hrx2025lucky-lab/flyarm-aerial-manipulation/assets_3d/README.md

# 3D 装配体

此目录用于存放机体与机械臂的 SolidWorks 装配体 / 零件文件。

URDF 与 STL 网格见上一级目录 `../urdf/`。
