hrx2025lucky-lab/flyarm-aerial-manipulation/docs/images/training_comparison/original/cmp_01_bar_level.png

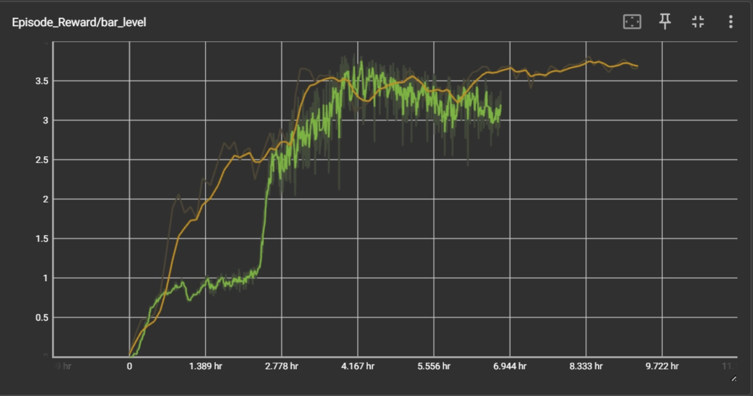
docs/images/training_comparison/original/cmp_01_bar_level.png
