hrx2025lucky-lab/flyarm-aerial-manipulation/docs/images/training_comparison/original/cmp_02_coop_grasp.png

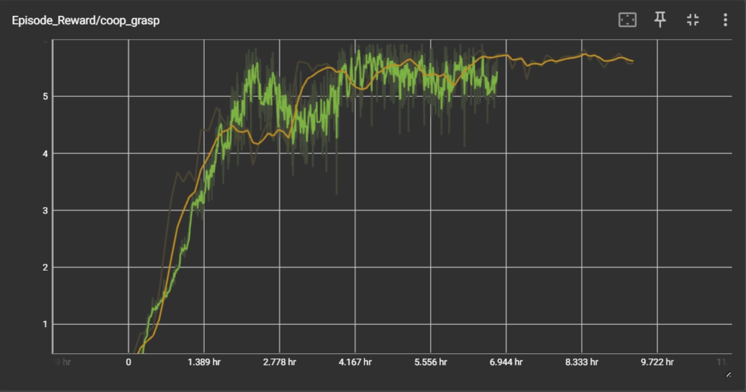
docs/images/training_comparison/original/cmp_02_coop_grasp.png
