hrx2025lucky-lab/flyarm-aerial-manipulation/docs/images/training_comparison/original/cmp_03_hold_bonus.png

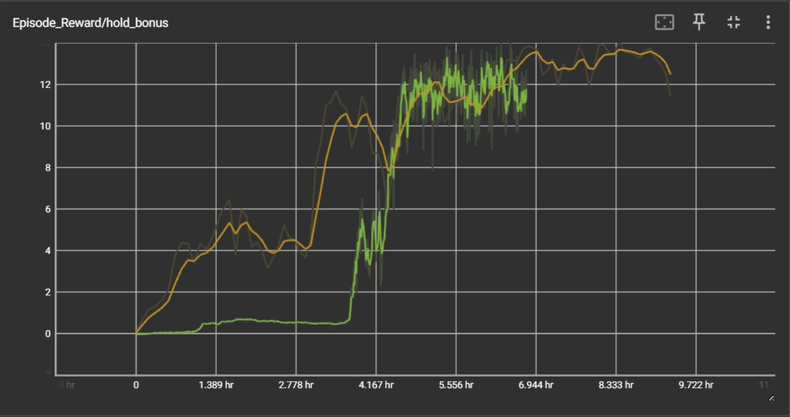
docs/images/training_comparison/original/cmp_03_hold_bonus.png
