hrx2025lucky-lab/flyarm-aerial-manipulation/docs/images/training_comparison/original/cmp_04_died.png

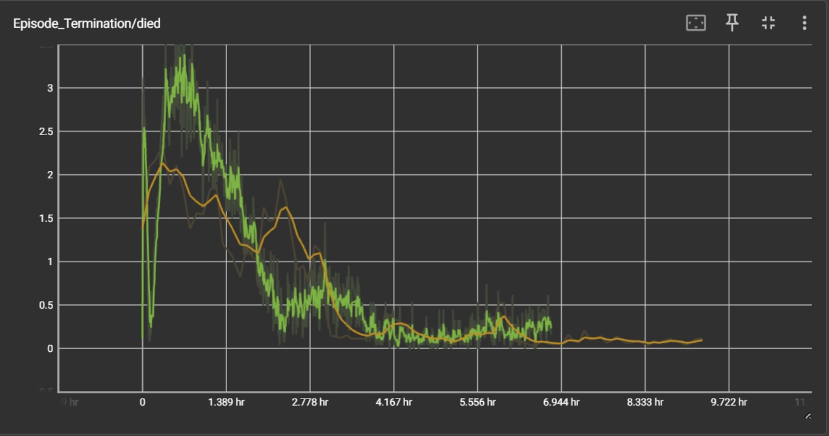
docs/images/training_comparison/original/cmp_04_died.png
