hrx2025lucky-lab/flyarm-aerial-manipulation/docs/images/training_comparison/original/cmp_05_all_contact_frac.png

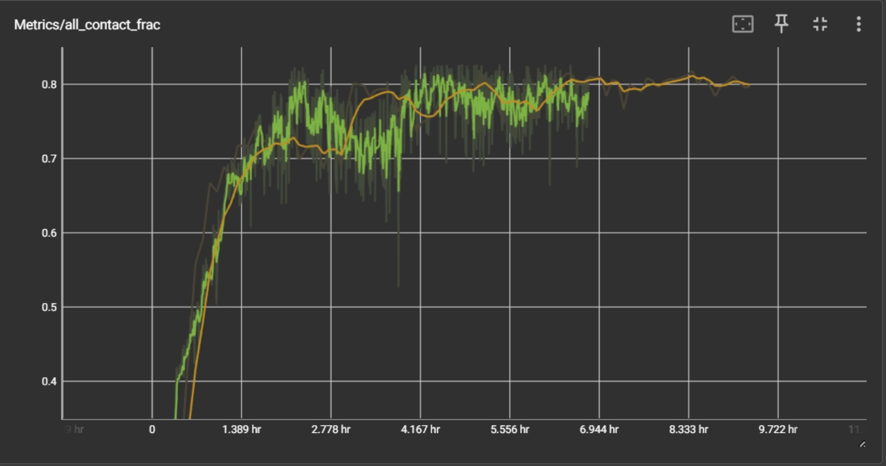
docs/images/training_comparison/original/cmp_05_all_contact_frac.png
