hrx2025lucky-lab/flyarm-aerial-manipulation/docs/images/training_comparison/original/cmp_06_contact_rate_0.png

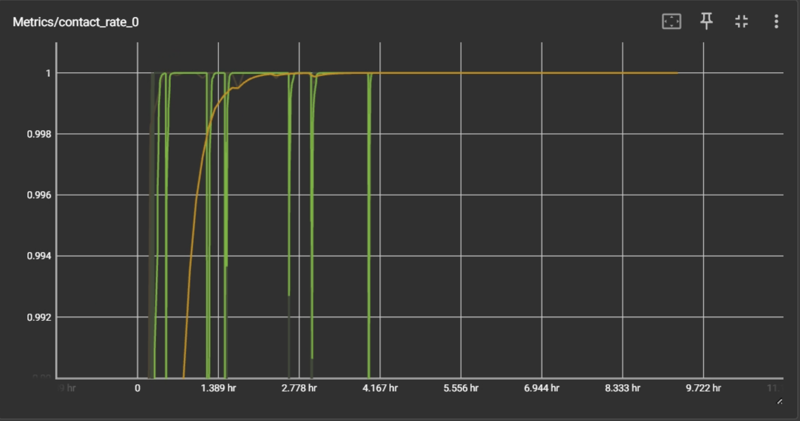
docs/images/training_comparison/original/cmp_06_contact_rate_0.png
