hrx2025lucky-lab/flyarm-aerial-manipulation/docs/images/training_comparison/original/cmp_07_contact_rate_1.png

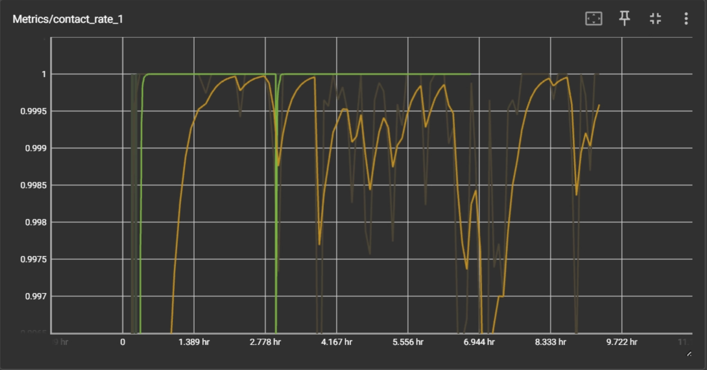
docs/images/training_comparison/original/cmp_07_contact_rate_1.png
