hrx2025lucky-lab/flyarm-aerial-manipulation/docs/images/training_comparison/original/cmp_08_max_bar_height.png

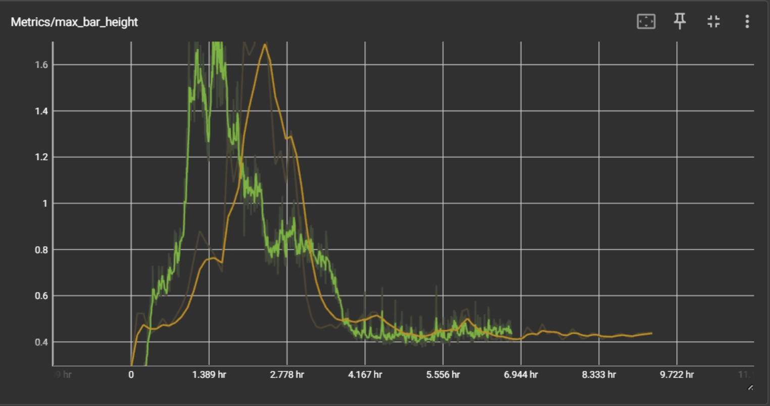
docs/images/training_comparison/original/cmp_08_max_bar_height.png
