hrx2025lucky-lab/flyarm-aerial-manipulation/docs/images/training_comparison/original/cmp_09_max_weak_finger_0.png

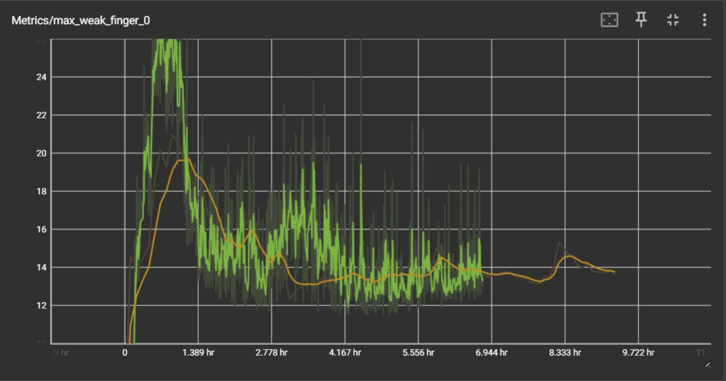
docs/images/training_comparison/original/cmp_09_max_weak_finger_0.png
