hrx2025lucky-lab/flyarm-aerial-manipulation/docs/images/training_comparison/original/cmp_10_max_weak_finger_1.png

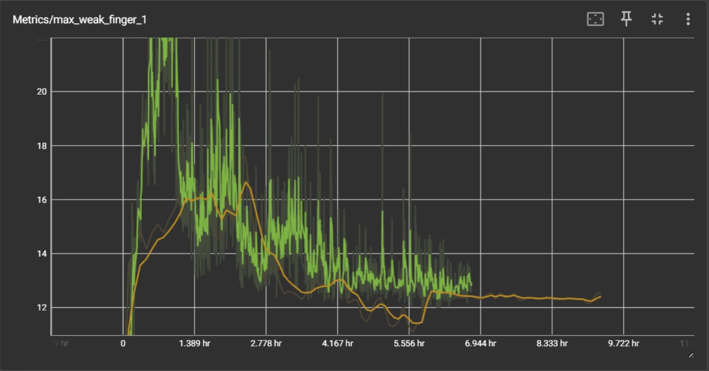
docs/images/training_comparison/original/cmp_10_max_weak_finger_1.png
