hrx2025lucky-lab/flyarm-aerial-manipulation/docs/images/training_comparison/original/cmp_11_success_rate.png

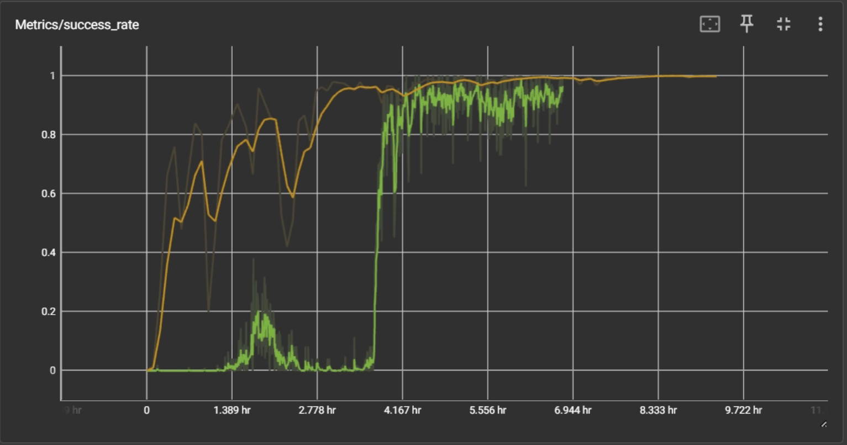
docs/images/training_comparison/original/cmp_11_success_rate.png
