hrx2025lucky-lab/flyarm-aerial-manipulation/assets_3d/3d打印零件/3d打印零件.SLDASM

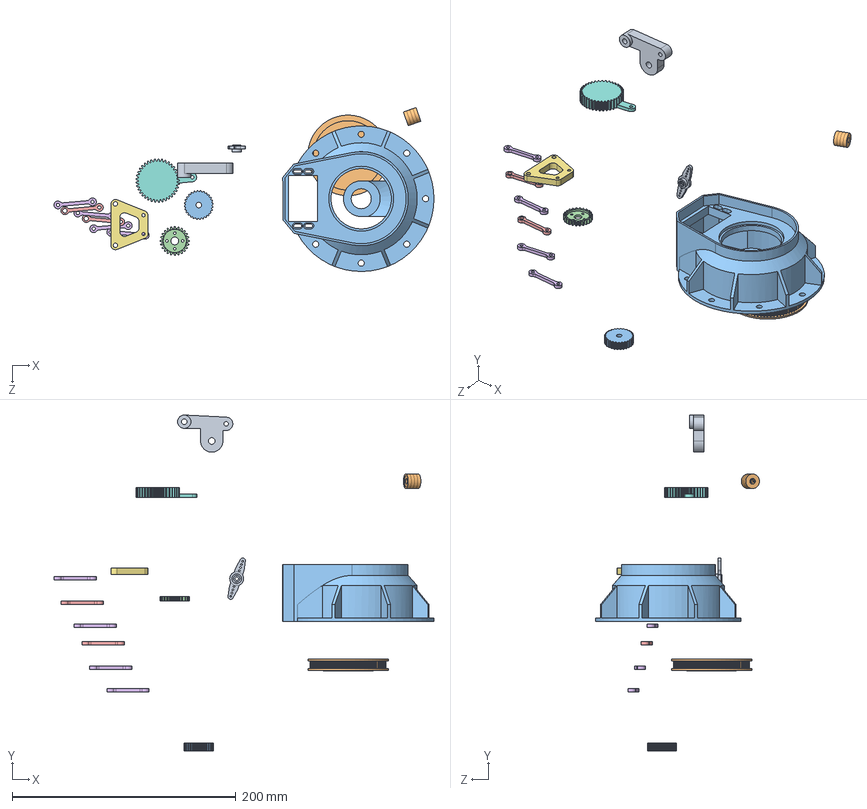
[picture p28: CAD file, 2026-09-01]
assets_3d/3d打印零件/3d打印零件.SLDASM
339.4 x 300.1 x 146.4 mm
固定底座
HTPA72S3M060_A_H8_b
三角形连杆
上从动齿直齿M1X37
夹爪连接件
grip part 3 x 4
从动齿轮轴下连杆 x 2
主动齿直齿M1X24
HTPA28S3M060_A_H5_b
B轴轴承压块 x 4
舵机单臂舵盘渲染2018
