hrx2025lucky-lab/flyarm-aerial-manipulation/assets_3d/旋转夹爪机械臂/HTPA28S3M060_A_H5.SLDASM

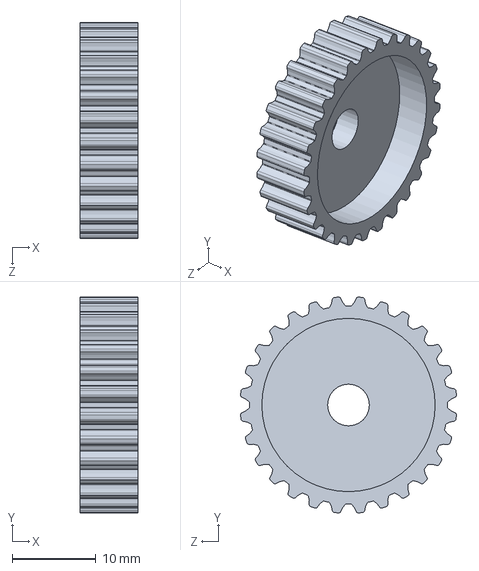
[picture p29: CAD file, 2026-09-01]
assets_3d/旋转夹爪机械臂/HTPA28S3M060_A_H5.SLDASM
7.00 x 25.9 x 25.9 mm
