hrx2025lucky-lab/flyarm-aerial-manipulation/assets_3d/旋转夹爪机械臂/HTPA72S3M060_A_H8.SLDASM

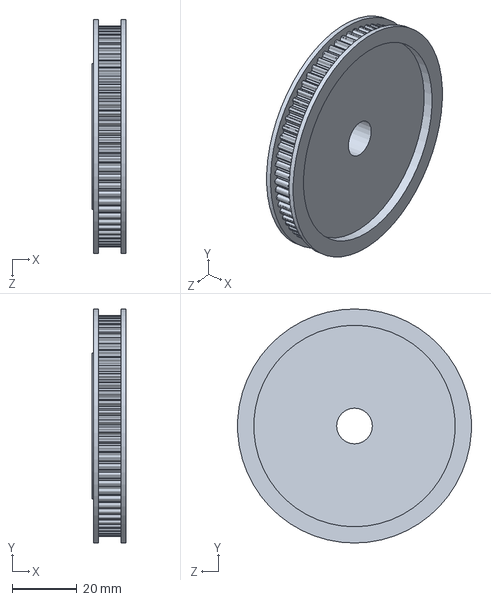
[picture p30: CAD file, 2026-09-01]
assets_3d/旋转夹爪机械臂/HTPA72S3M060_A_H8.SLDASM
10.5 x 72.0 x 71.9 mm
