hrx2025lucky-lab/flyarm-aerial-manipulation/assets_3d/3d打印零件/夹爪装配体 - grip part 3-4.STL

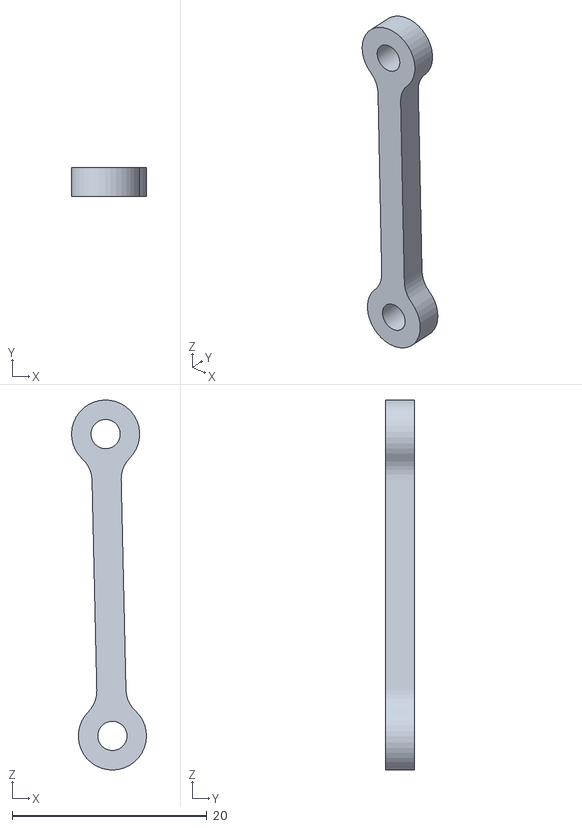
[picture p31: CAD file, 2026-09-01]
assets_3d/3d打印零件/夹爪装配体 - grip part 3-4.STL
7.70 x 3.00 x 38.0
