hrx2025lucky-lab/flyarm-aerial-manipulation/assets_3d/旋转夹爪机械臂/方案-旋转底座.SLDPRT

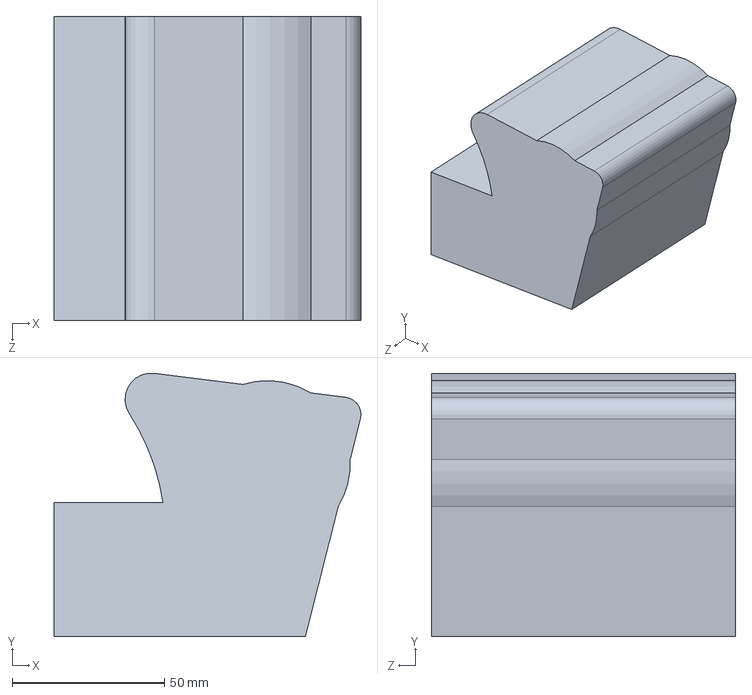
[picture p32: CAD file, 2026-09-01]
assets_3d/旋转夹爪机械臂/方案-旋转底座.SLDPRT
100.9 x 86.5 x 100.0 mm
