hrx2025lucky-lab/flyarm-aerial-manipulation/urdf/meshes/link_bc.STL

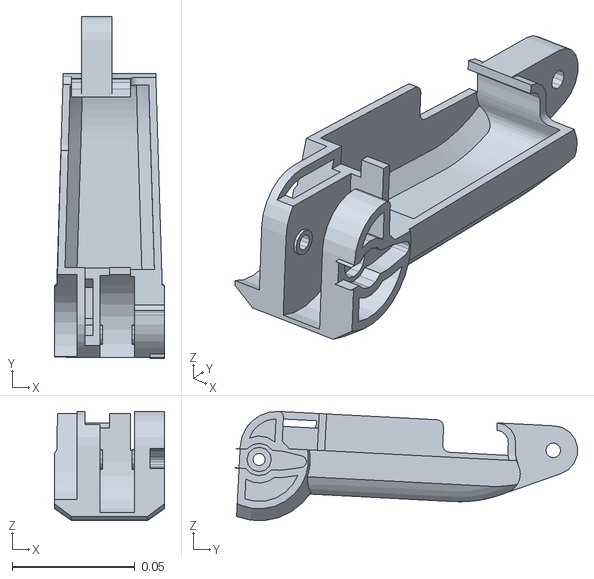
[picture p33: CAD file, 2026-09-01]
urdf/meshes/link_bc.STL
0.045 x 0.139 x 0.0445
