hrx2025lucky-lab/flyarm-aerial-manipulation/urdf/meshes/parallel_gripper/pg_right_finger.STL

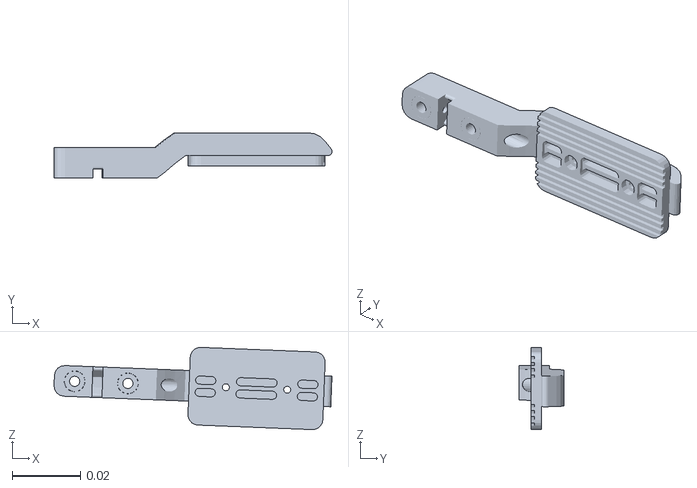
[picture p34: CAD file, 2026-09-01]
urdf/meshes/parallel_gripper/pg_right_finger.STL
0.0815 x 0.0133 x 0.0241
