hrx2025lucky-lab/flyarm-aerial-manipulation/assets_3d/平行夹爪机械臂/内六角圆柱头螺钉 M2x4.SLDPRT

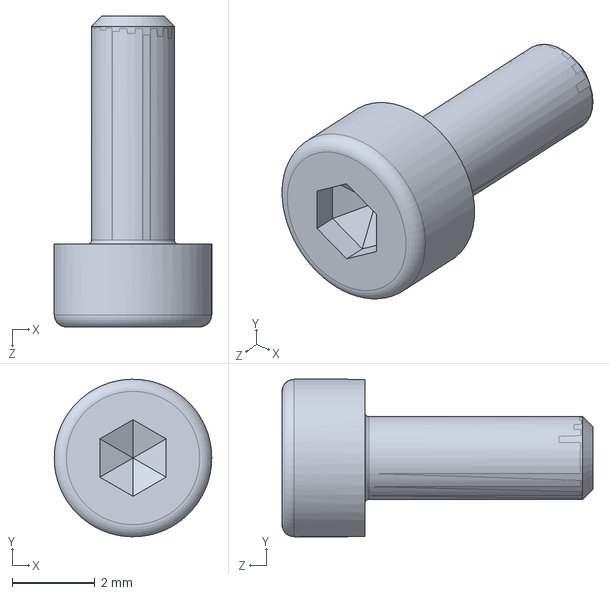
[picture p35: CAD file, 2026-09-01]
assets_3d/平行夹爪机械臂/内六角圆柱头螺钉 M2x4.SLDPRT
3.80 x 3.80 x 7.50 mm
