hrx2025lucky-lab/flyarm-aerial-manipulation/assets_3d/旋转夹爪机械臂/上从动齿直齿M1X37.SLDPRT

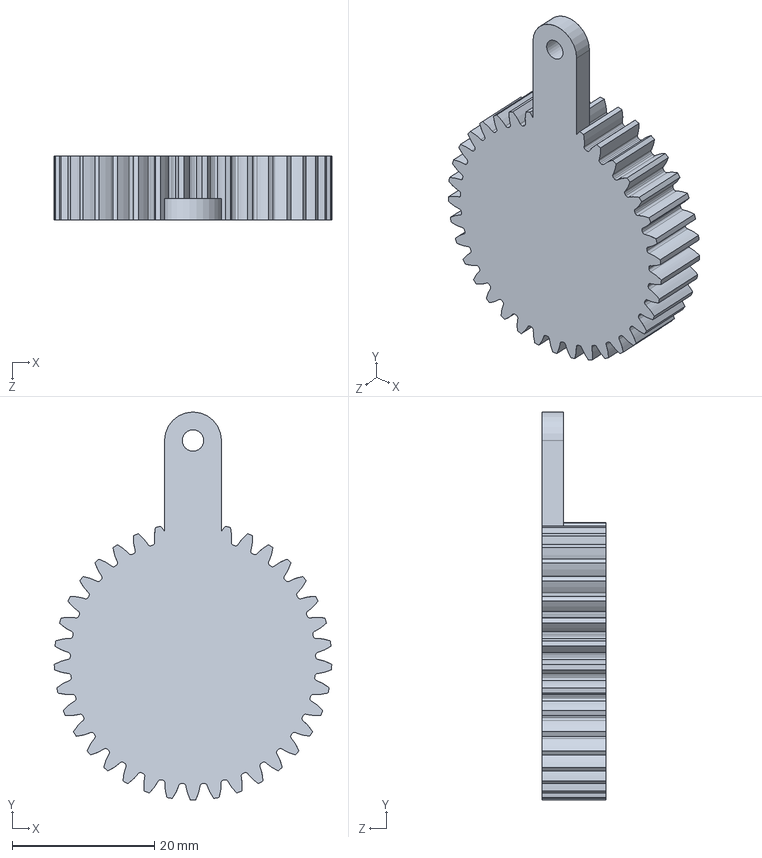
[picture p36: CAD file, 2026-09-01]
assets_3d/旋转夹爪机械臂/上从动齿直齿M1X37.SLDPRT
39.0 x 54.5 x 9.00 mm
