hrx2025lucky-lab/flyarm-aerial-manipulation/urdf/meshes/link_cd.STL

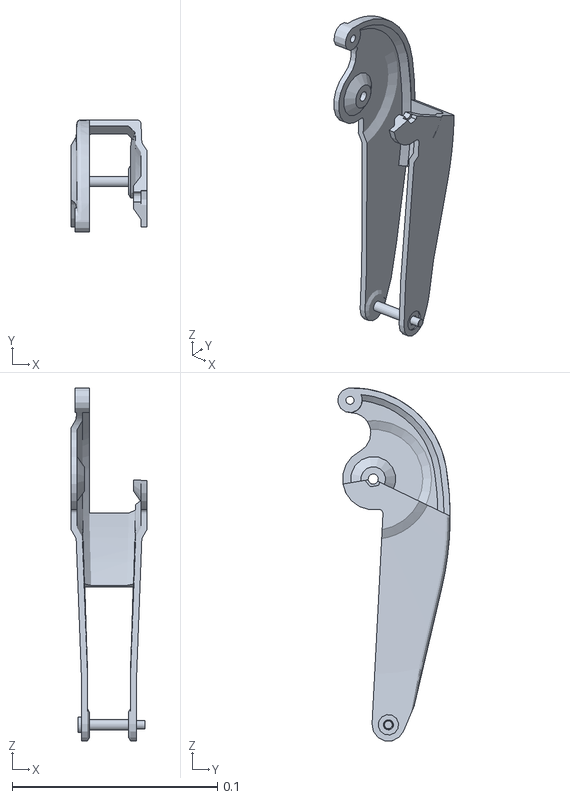
[picture p37: CAD file, 2026-09-01]
urdf/meshes/link_cd.STL
0.037 x 0.0547 x 0.172
