hrx2025lucky-lab/flyarm-aerial-manipulation/urdf/meshes/parallel_gripper/pg_gripper_base.STL

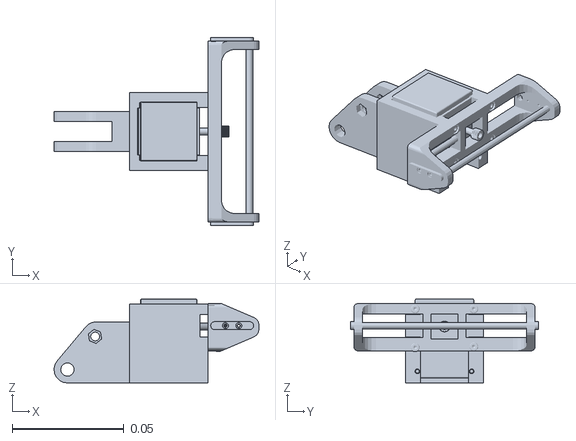
[picture p38: CAD file, 2026-09-01]
urdf/meshes/parallel_gripper/pg_gripper_base.STL
0.0916 x 0.084 x 0.0375
