hrx2025lucky-lab/flyarm-aerial-manipulation/assets_3d/3d打印零件/夹爪装配体 - 从动齿轮轴下连杆-2.STL

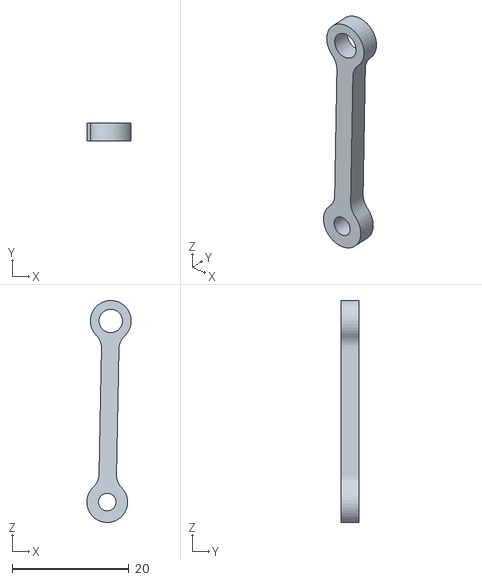
[picture p39: CAD file, 2026-09-01]
assets_3d/3d打印零件/夹爪装配体 - 从动齿轮轴下连杆-2.STL
7.60 x 3.00 x 38.0
