hrx2025lucky-lab/flyarm-aerial-manipulation/assets_3d/旋转夹爪机械臂/三角连接件.SLDPRT

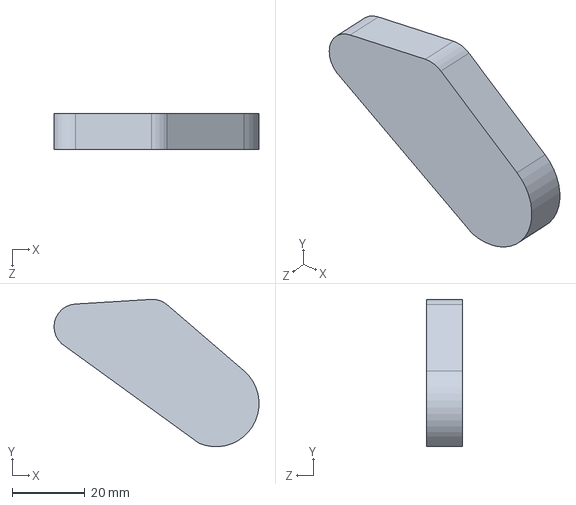
[picture p40: CAD file, 2026-09-01]
assets_3d/旋转夹爪机械臂/三角连接件.SLDPRT
56.3 x 40.4 x 10.0 mm
