hrx2025lucky-lab/flyarm-aerial-manipulation/urdf/meshes/rl_rotor.STL

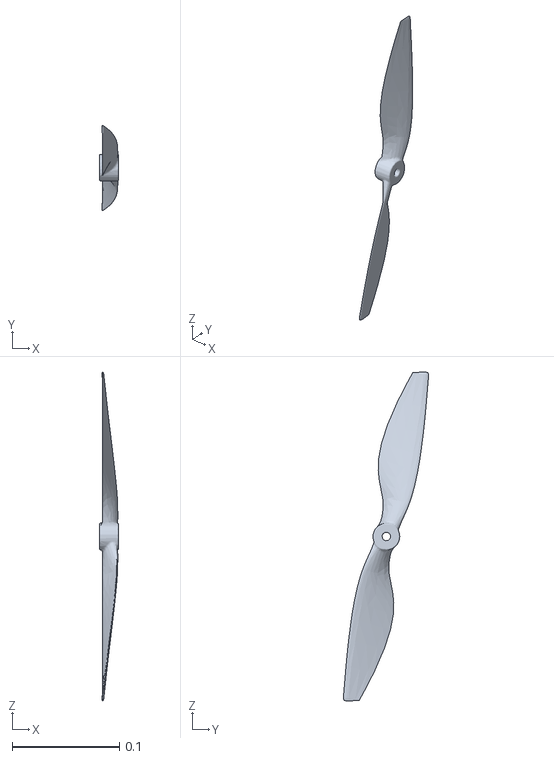
[picture p41: CAD file, 2026-09-01]
urdf/meshes/rl_rotor.STL
0.018 x 0.0795 x 0.307
