hrx2025lucky-lab/flyarm-aerial-manipulation/assets_3d/3d打印零件/CD轴连杆.STL

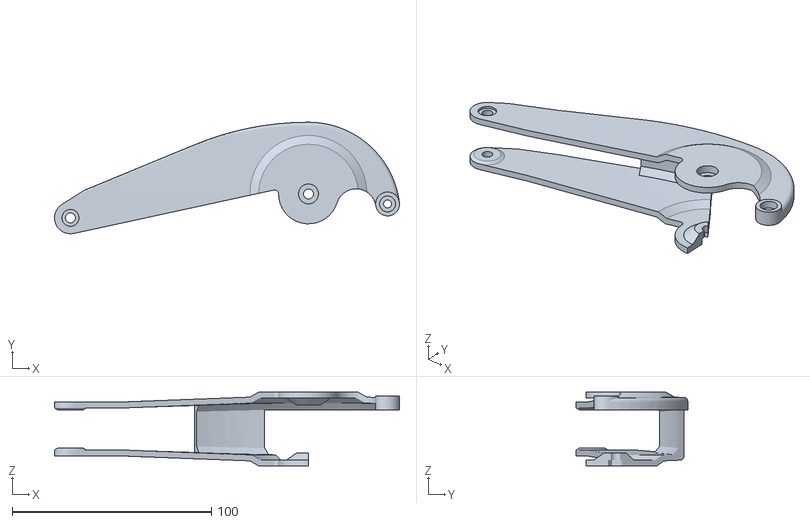
[picture p42: CAD file, 2026-09-01]
assets_3d/3d打印零件/CD轴连杆.STL
173.1 x 56.0 x 37.0
