hrx2025lucky-lab/flyarm-aerial-manipulation/assets_3d/平行夹爪机械臂/舵机臂.SLDPRT

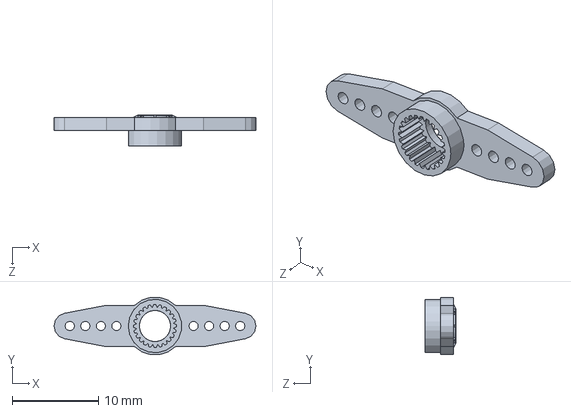
[picture p43: CAD file, 2026-09-01]
assets_3d/平行夹爪机械臂/舵机臂.SLDPRT
23.4 x 6.64 x 3.60 mm
