hrx2025lucky-lab/flyarm-aerial-manipulation/urdf/meshes/arm_base_rotate.STL

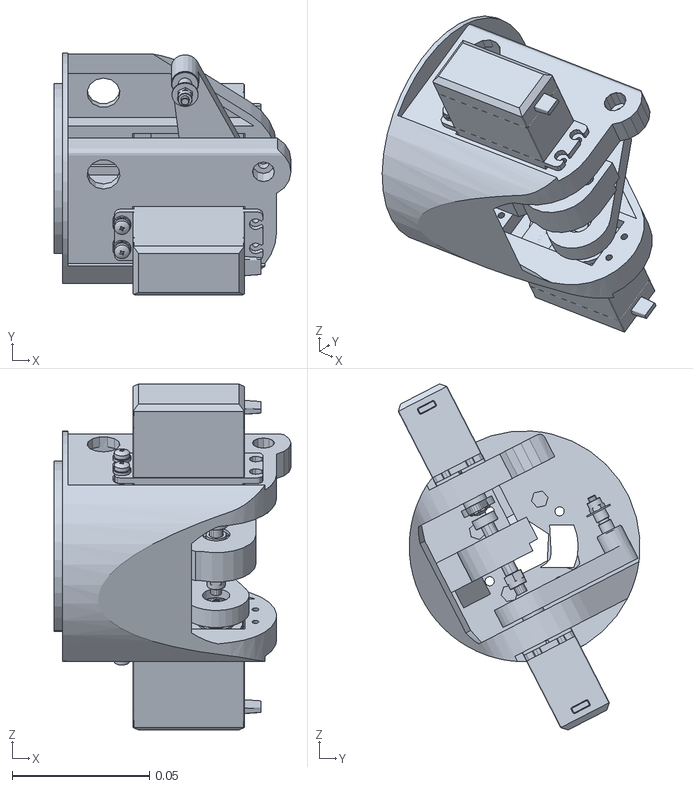
[picture p44: CAD file, 2026-09-01]
urdf/meshes/arm_base_rotate.STL
0.0862 x 0.0879 x 0.126
