hrx2025lucky-lab/flyarm-aerial-manipulation/assets_3d/平行夹爪机械臂/固定底座.SLDPRT

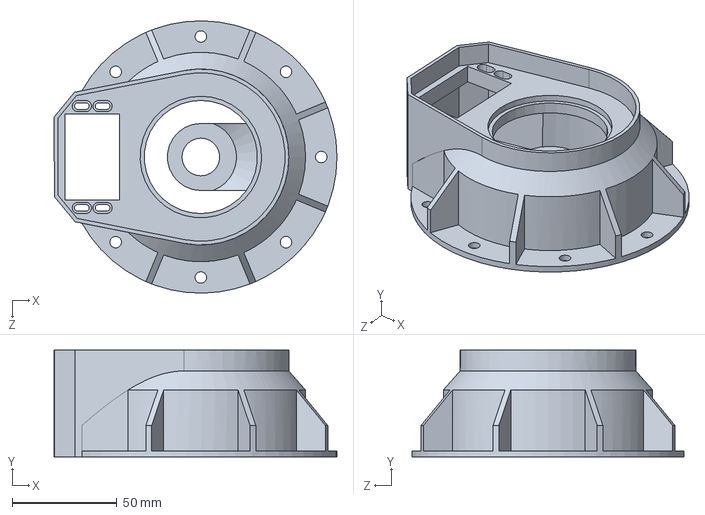
[picture p45: CAD file, 2026-09-01]
assets_3d/平行夹爪机械臂/固定底座.SLDPRT
135.1 x 51.0 x 130.0 mm
