hrx2025lucky-lab/flyarm-aerial-manipulation/assets_3d/空中机械臂/opensource_arm小圆盘.SLDPRT

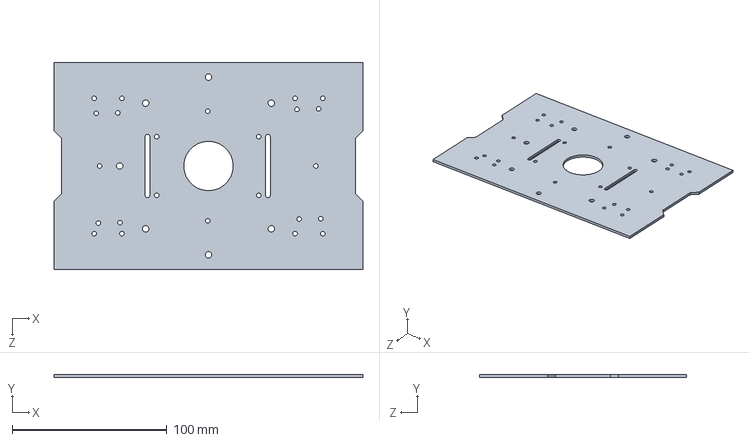
[picture p46: CAD file, 2026-09-01]
assets_3d/空中机械臂/opensource_arm小圆盘.SLDPRT
200.0 x 2.00 x 134.2 mm
