hrx2025lucky-lab/flyarm-aerial-manipulation/urdf/meshes/base_link.STL

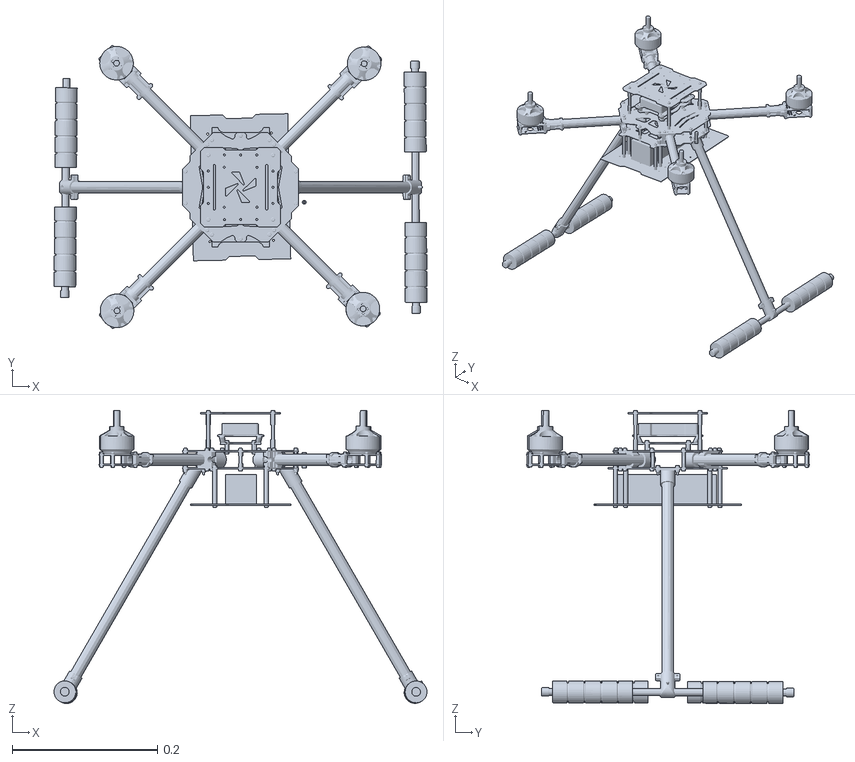
[picture p47: CAD file, 2026-09-01]
urdf/meshes/base_link.STL
0.514 x 0.389 x 0.404
