hrx2025lucky-lab/flyarm-aerial-manipulation/assets_3d/平行夹爪机械臂/B轴轴承压块.SLDPRT

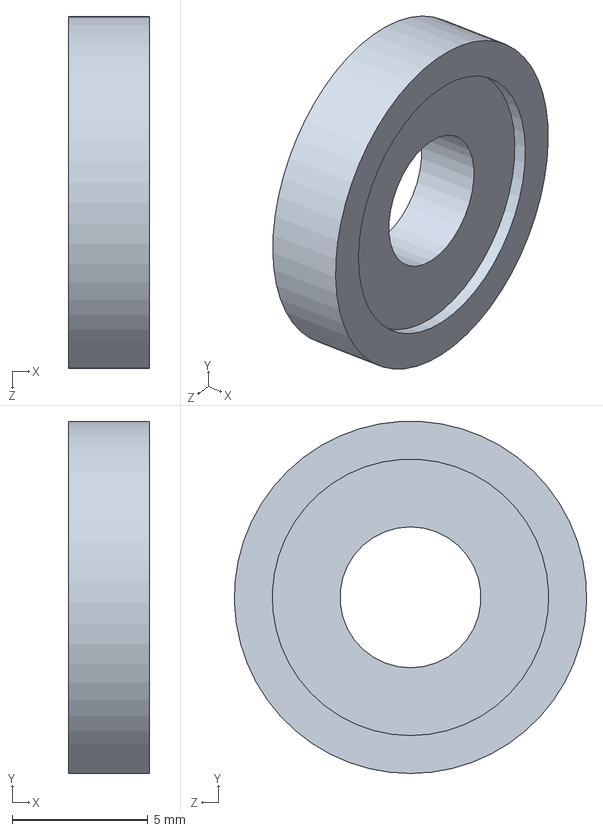
[picture p48: CAD file, 2026-09-01]
assets_3d/平行夹爪机械臂/B轴轴承压块.SLDPRT
3.00 x 13.0 x 13.0 mm
