hrx2025lucky-lab/flyarm-aerial-manipulation/urdf/meshes/gripper_left.STL

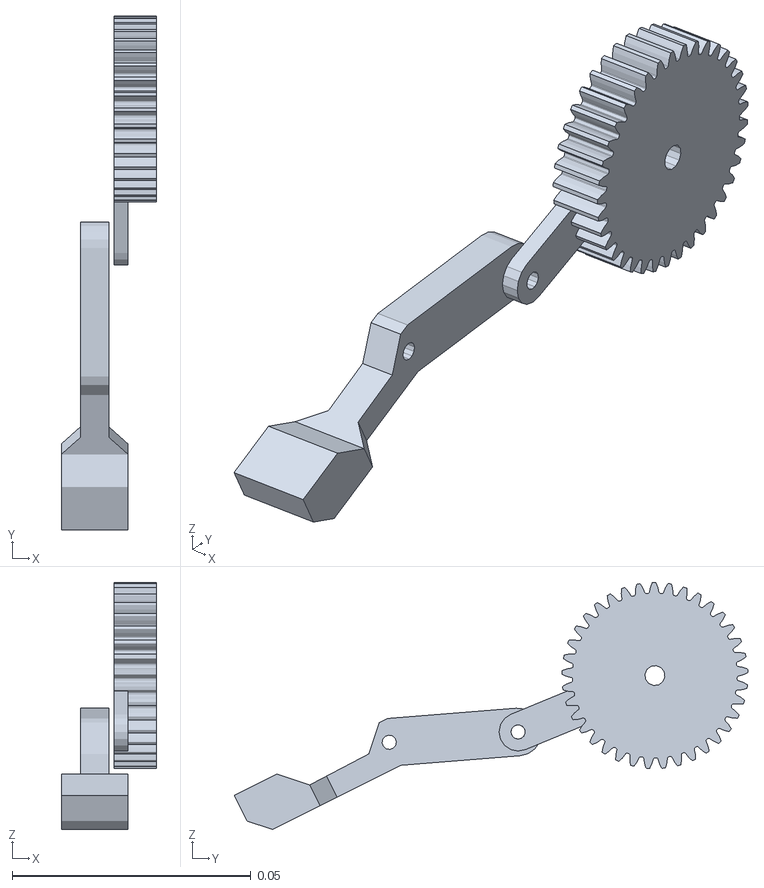
[picture p49: CAD file, 2026-09-01]
urdf/meshes/gripper_left.STL
0.02 x 0.108 x 0.0518
