hrx2025lucky-lab/flyarm-aerial-manipulation/assets_3d/3d打印零件/从动齿轮轴下连杆.STL

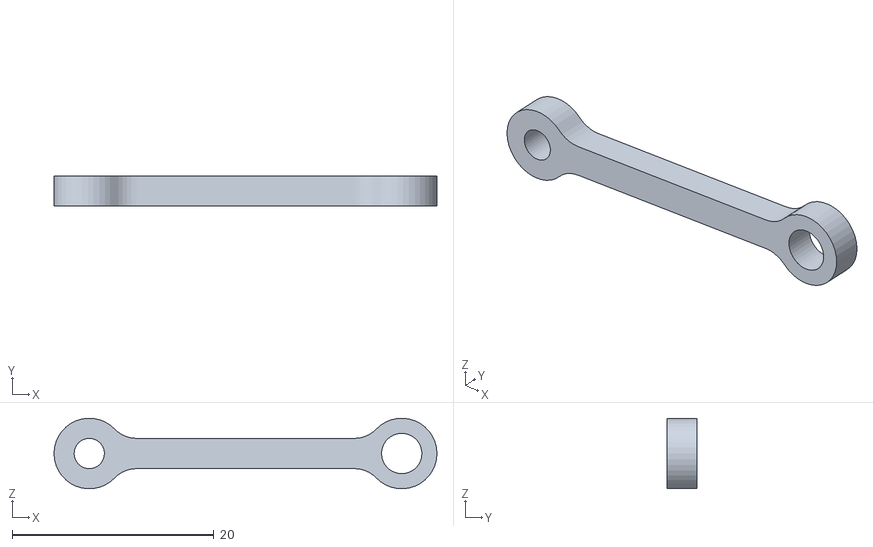
[picture p50: CAD file, 2026-09-01]
assets_3d/3d打印零件/从动齿轮轴下连杆.STL
38.0 x 3.00 x 6.99
