hrx2025lucky-lab/flyarm-aerial-manipulation/assets_3d/平行夹爪机械臂/三角形连杆.SLDPRT

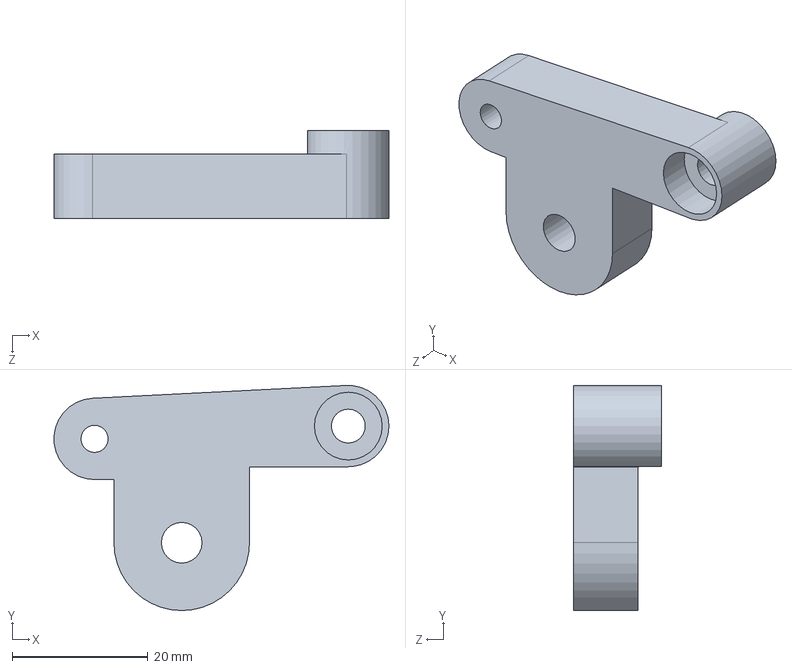
[picture p51: CAD file, 2026-09-01]
assets_3d/平行夹爪机械臂/三角形连杆.SLDPRT
49.4 x 33.2 x 13.0 mm
