hrx2025lucky-lab/flyarm-aerial-manipulation/assets_3d/旋转夹爪机械臂/主动齿直齿M1X24.SLDPRT

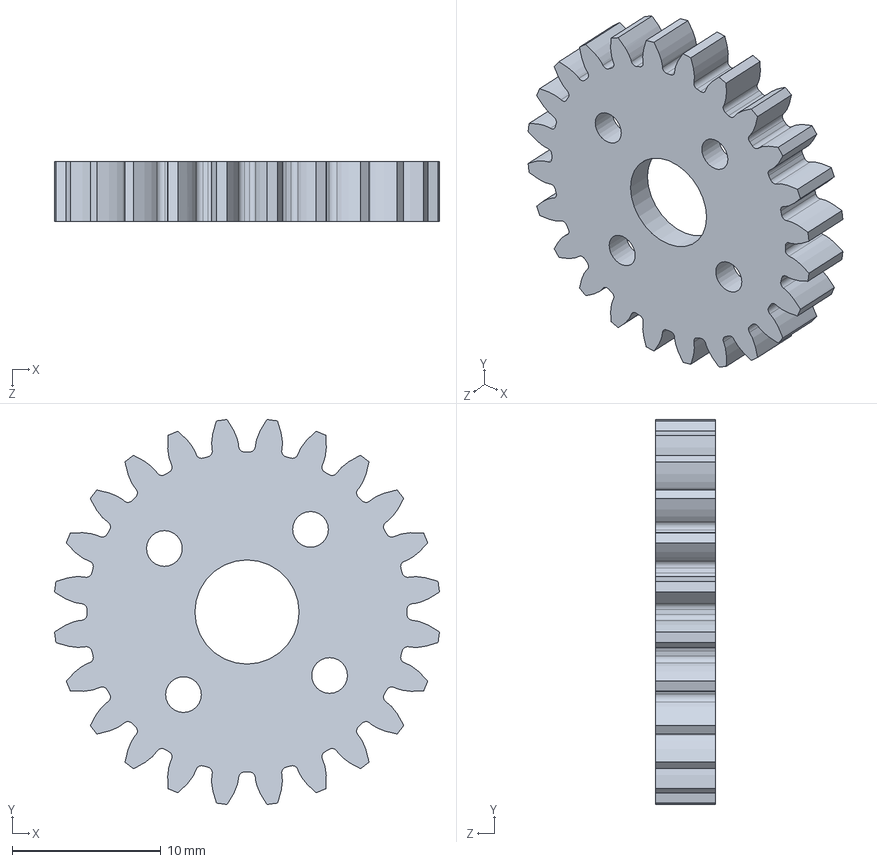
[picture p52: CAD file, 2026-09-01]
assets_3d/旋转夹爪机械臂/主动齿直齿M1X24.SLDPRT
25.9 x 25.9 x 4.00 mm
