hrx2025lucky-lab/flyarm-aerial-manipulation/assets_3d/空中机械臂/支撑螺柱.SLDPRT

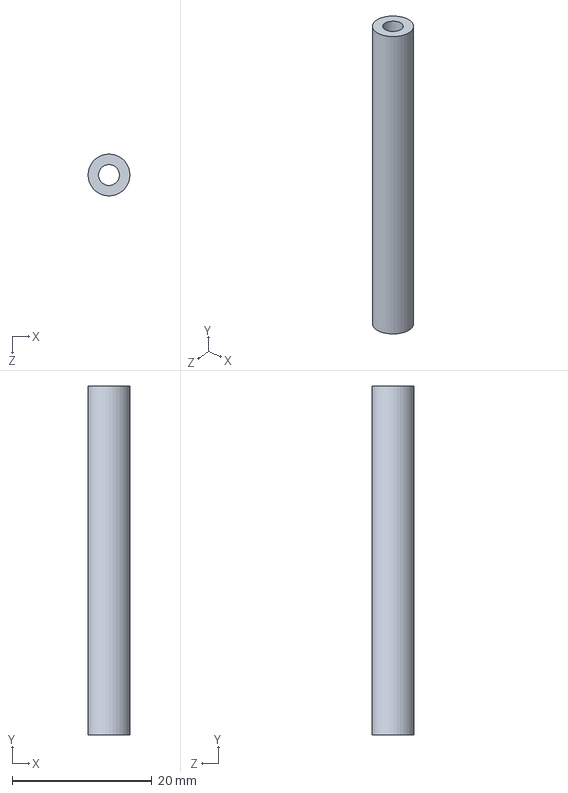
[picture p53: CAD file, 2026-09-01]
assets_3d/空中机械臂/支撑螺柱.SLDPRT
6.00 x 50.0 x 6.00 mm
