hrx2025lucky-lab/flyarm-aerial-manipulation/urdf/meshes/fl_rotor.STL

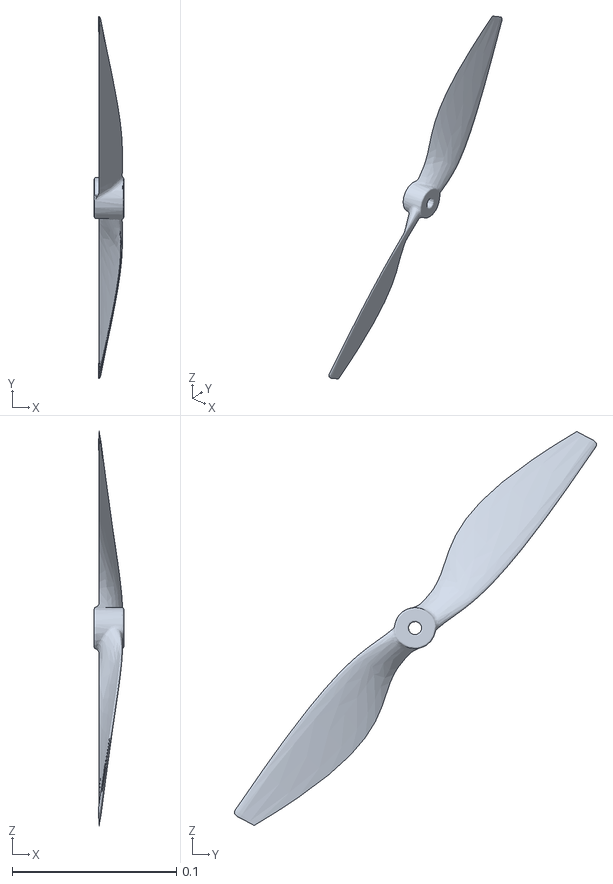
[picture p54: CAD file, 2026-09-01]
urdf/meshes/fl_rotor.STL
0.018 x 0.221 x 0.24
