hrx2025lucky-lab/flyarm-aerial-manipulation/assets_3d/3d打印零件/B1C连杆.STL

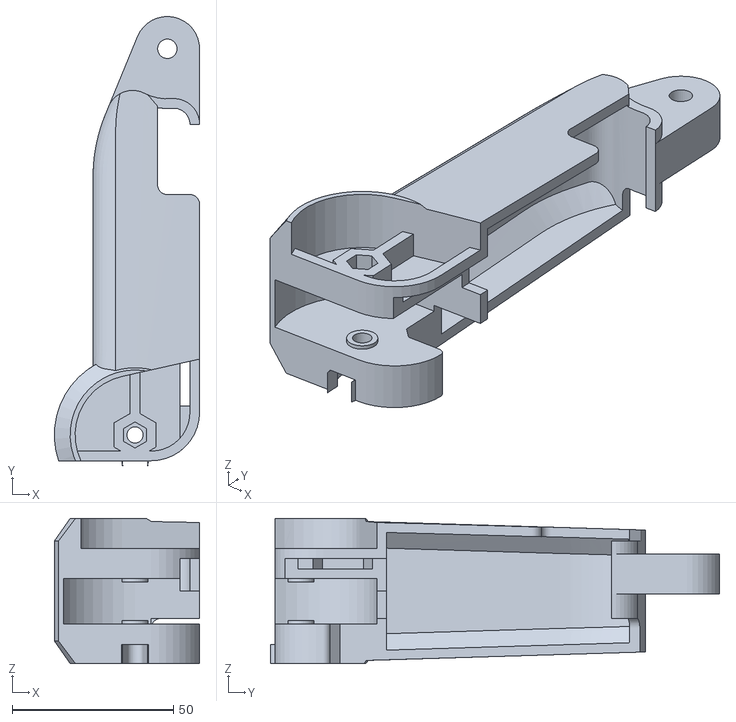
[picture p55: CAD file, 2026-09-01]
assets_3d/3d打印零件/B1C连杆.STL
45.0 x 139.0 x 45.0
