hrx2025lucky-lab/flyarm-aerial-manipulation/assets_3d/平行夹爪机械臂/爪1.SLDPRT

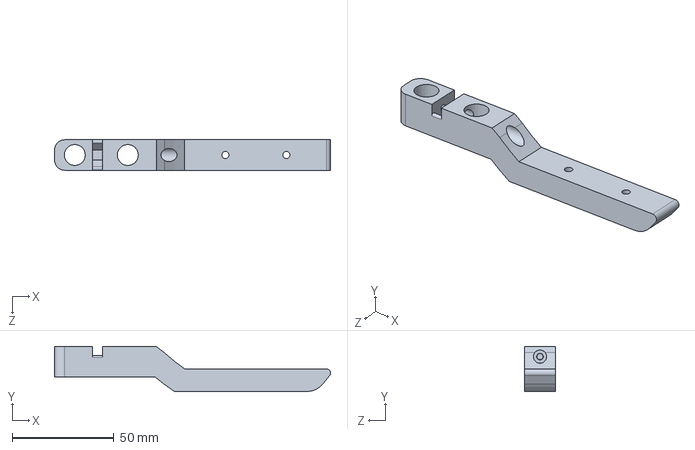
[picture p56: CAD file, 2026-09-01]
assets_3d/平行夹爪机械臂/爪1.SLDPRT
135.7 x 22.1 x 15.0 mm
