hrx2025lucky-lab/flyarm-aerial-manipulation/assets_3d/旋转夹爪机械臂/HTBN255S3M_60_info_1_28_72.SLDPRT

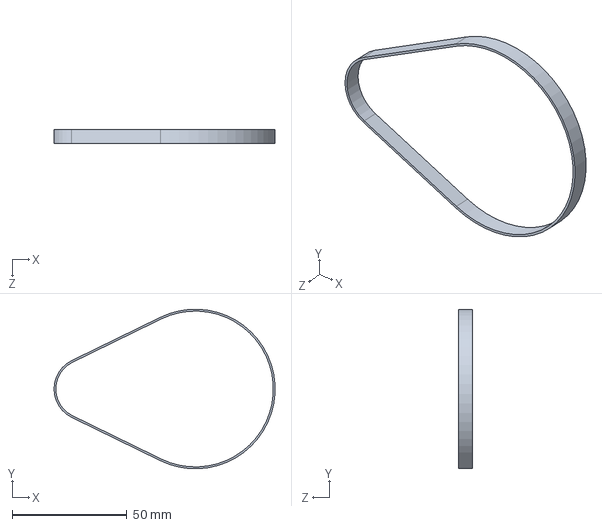
[picture p57: CAD file, 2026-09-01]
assets_3d/旋转夹爪机械臂/HTBN255S3M_60_info_1_28_72.SLDPRT
96.4 x 69.5 x 6.00 mm
