hrx2025lucky-lab/flyarm-aerial-manipulation/urdf/meshes/arm_base.STL

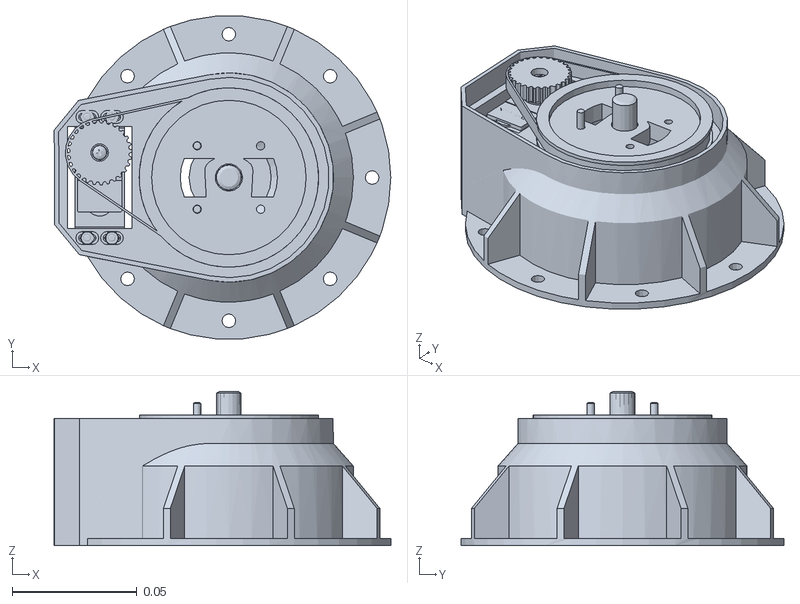
[picture p58: CAD file, 2026-09-01]
urdf/meshes/arm_base.STL
0.135 x 0.13 x 0.062
