hrx2025lucky-lab/flyarm-aerial-manipulation/assets_3d/3d打印零件/夹爪装配体 - ￠4×M3×30 轴肩螺丝 2018-2.STL

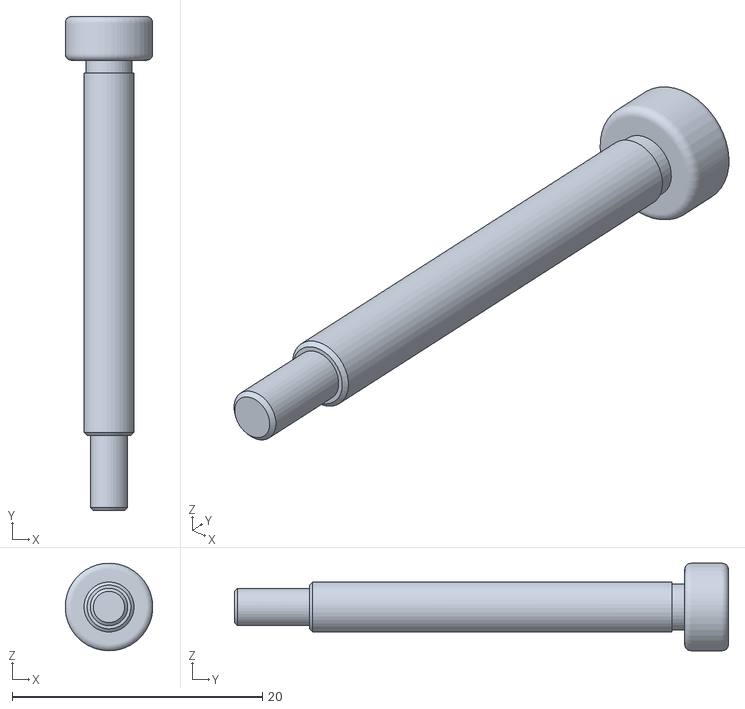
[picture p59: CAD file, 2026-09-01]
assets_3d/3d打印零件/夹爪装配体 - ￠4×M3×30 轴肩螺丝 2018-2.STL
6.99 x 39.5 x 7.00
