hrx2025lucky-lab/flyarm-aerial-manipulation/assets_3d/平行夹爪机械臂/GB／T70．1-2000内六角圆柱头螺钉M3×12.SLDPRT

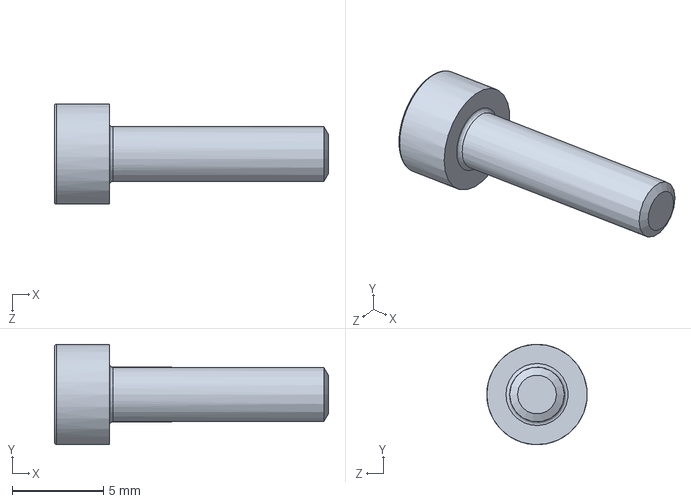
[picture p60: CAD file, 2026-09-01]
assets_3d/平行夹爪机械臂/GB／T70．1-2000内六角圆柱头螺钉M3×12.SLDPRT
15.0 x 5.49 x 5.50 mm
