hrx2025lucky-lab/flyarm-aerial-manipulation/assets_3d/旋转夹爪机械臂/d轴支架.SLDPRT

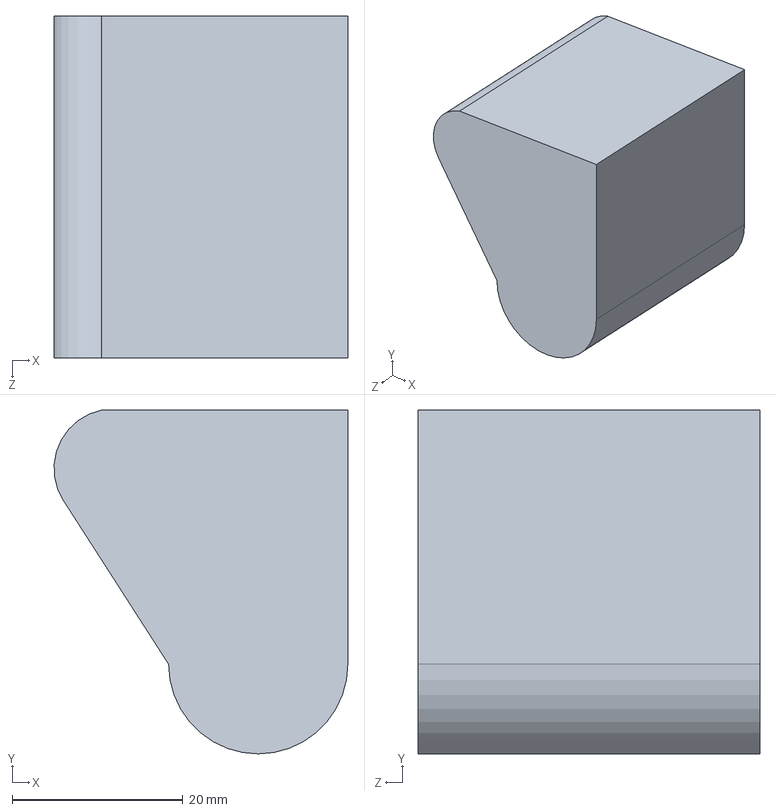
[picture p61: CAD file, 2026-09-01]
assets_3d/旋转夹爪机械臂/d轴支架.SLDPRT
34.4 x 40.2 x 40.0 mm
