hrx2025lucky-lab/flyarm-aerial-manipulation/urdf/meshes/gripper_right.STL

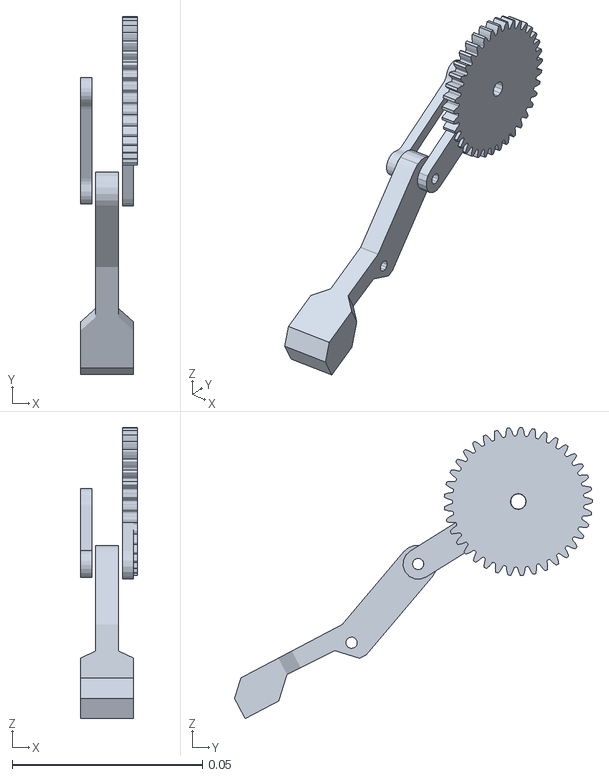
[picture p62: CAD file, 2026-09-01]
urdf/meshes/gripper_right.STL
0.015 x 0.0941 x 0.0765
