hrx2025lucky-lab/flyarm-aerial-manipulation/assets_3d/3d打印零件/上水平连杆.STL

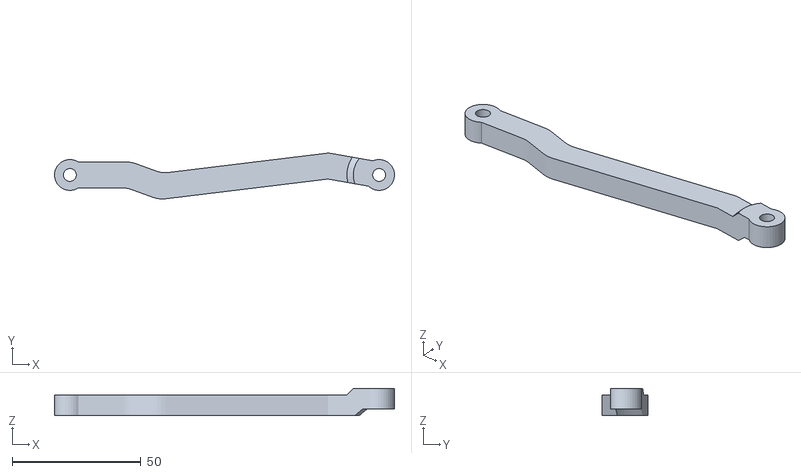
[picture p63: CAD file, 2026-09-01]
assets_3d/3d打印零件/上水平连杆.STL
132.0 x 17.9 x 10.5
