hrx2025lucky-lab/flyarm-aerial-manipulation/assets_3d/平行夹爪机械臂/夹爪连接件.SLDPRT

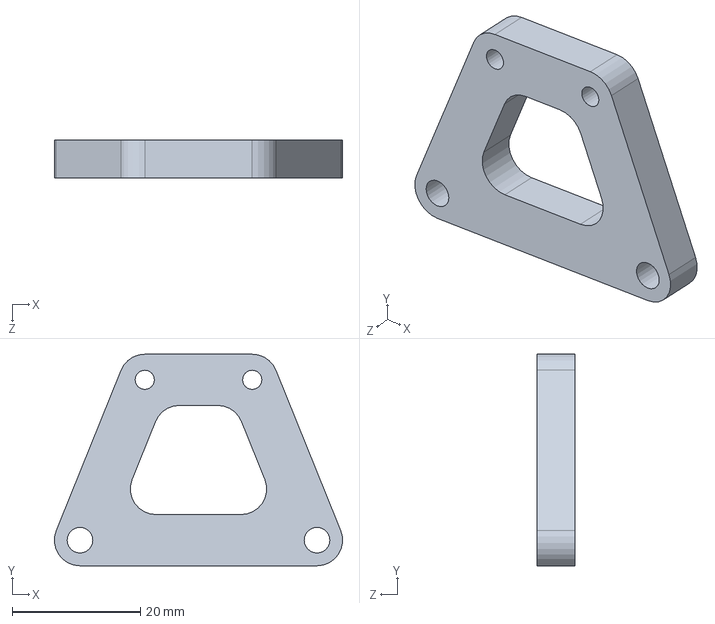
[picture p64: CAD file, 2026-09-01]
assets_3d/平行夹爪机械臂/夹爪连接件.SLDPRT
45.0 x 33.0 x 6.00 mm
