hrx2025lucky-lab/flyarm-aerial-manipulation/urdf/meshes/gripper_base.STL

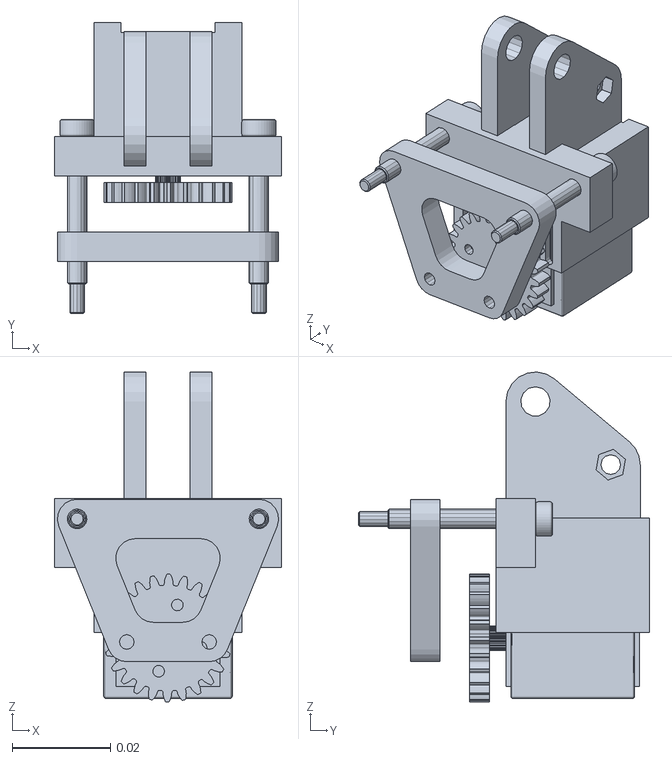
[picture p65: CAD file, 2026-09-01]
urdf/meshes/gripper_base.STL
0.0462 x 0.0592 x 0.0671
