hrx2025lucky-lab/flyarm-aerial-manipulation/assets_3d/平行夹爪机械臂/GB／T889．2-20001型非金属嵌件六角锁紧螺母细牙M10.SLDPRT

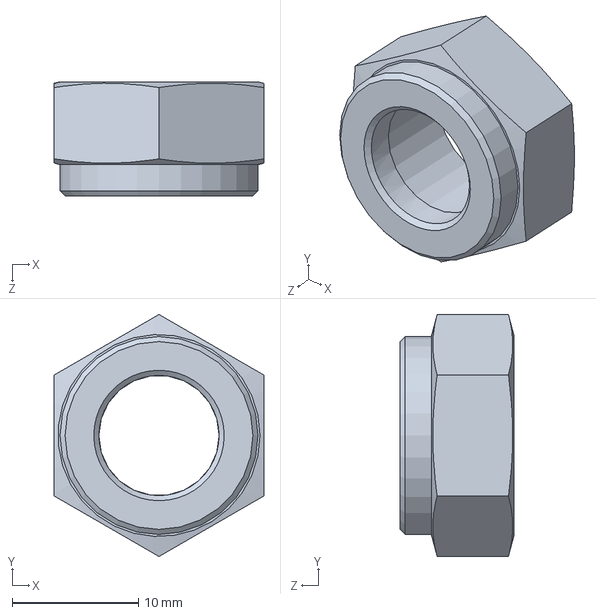
[picture p66: CAD file, 2026-09-01]
assets_3d/平行夹爪机械臂/GB／T889．2-20001型非金属嵌件六角锁紧螺母细牙M10.SLDPRT
16.6 x 19.2 x 9.00 mm
