hrx2025lucky-lab/flyarm-aerial-manipulation/urdf/meshes/rr_rotor.STL

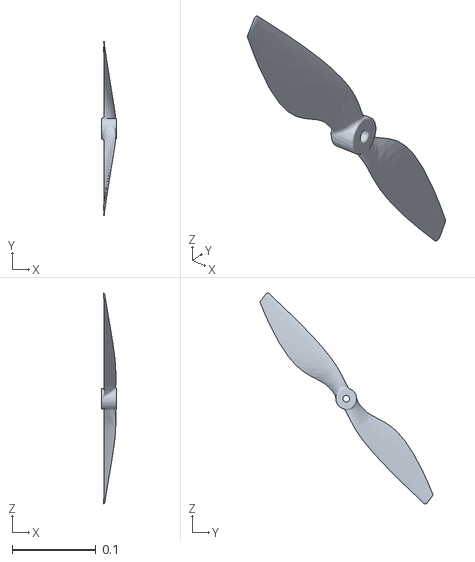
[picture p67: CAD file, 2026-09-01]
urdf/meshes/rr_rotor.STL
0.018 x 0.207 x 0.252
