hrx2025lucky-lab/flyarm-aerial-manipulation/assets_3d/3d打印零件/A轴轴承压块.STL

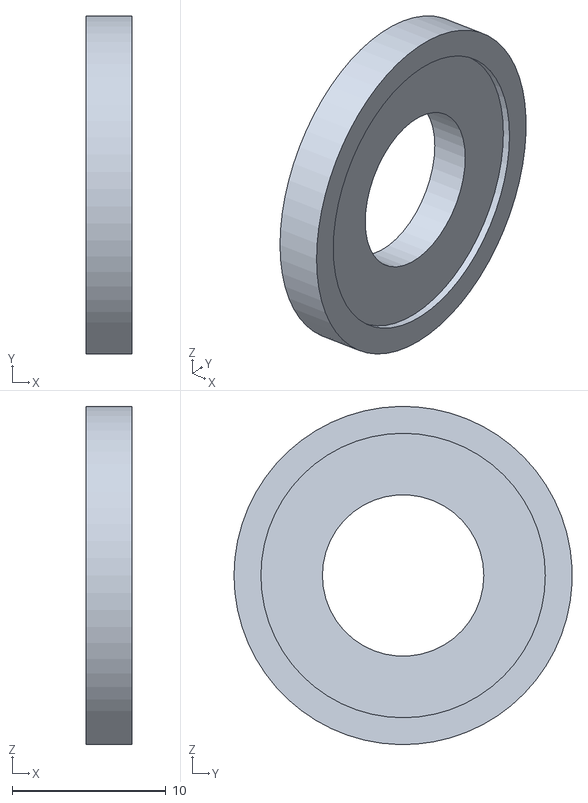
[picture p68: CAD file, 2026-09-01]
assets_3d/3d打印零件/A轴轴承压块.STL
3.00 x 22.0 x 22.0
