hrx2025lucky-lab/flyarm-aerial-manipulation/assets_3d/平行夹爪机械臂/滚珠轴承.SLDPRT

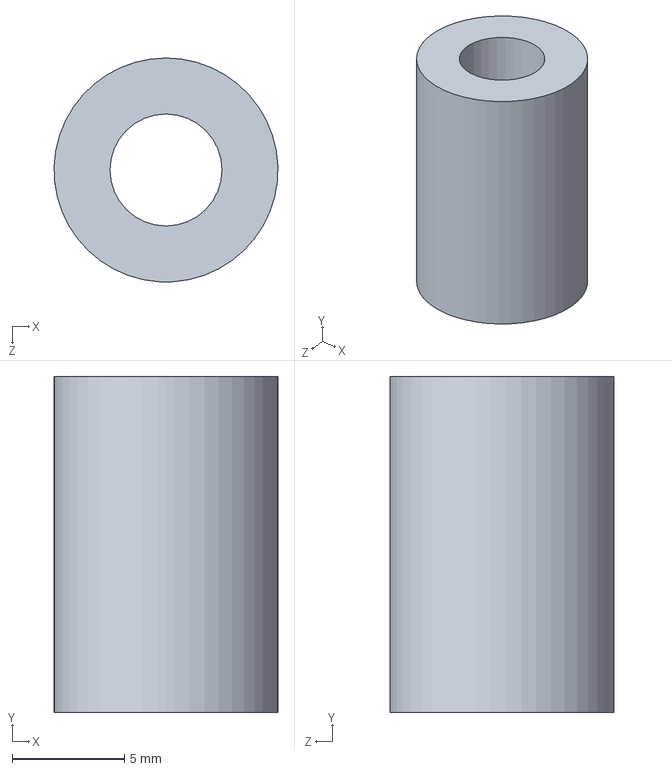
[picture p69: CAD file, 2026-09-01]
assets_3d/平行夹爪机械臂/滚珠轴承.SLDPRT
9.99 x 15.0 x 10.0 mm
