hrx2025lucky-lab/flyarm-aerial-manipulation/assets_3d/旋转夹爪机械臂/方案-底座.SLDPRT

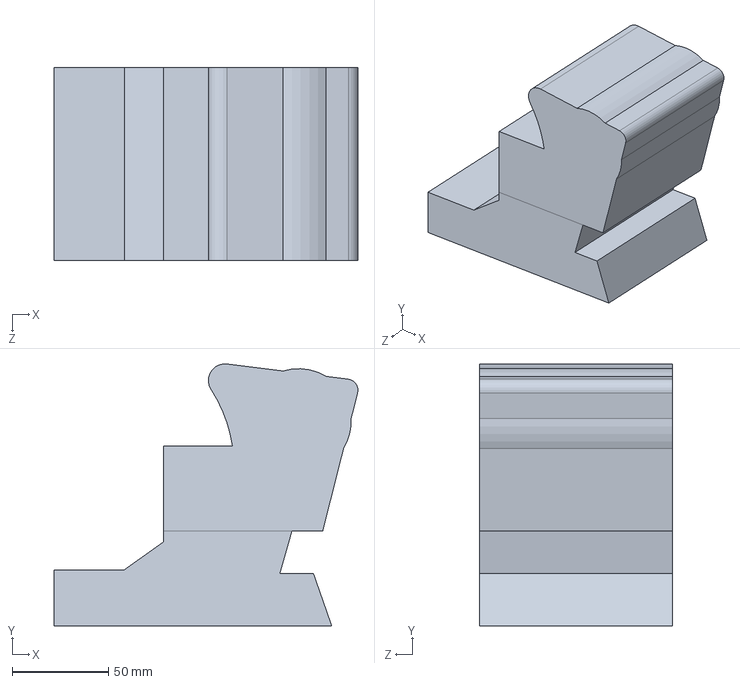
[picture p70: CAD file, 2026-09-01]
assets_3d/旋转夹爪机械臂/方案-底座.SLDPRT
157.6 x 135.8 x 100.0 mm
