hrx2025lucky-lab/flyarm-aerial-manipulation/urdf/meshes/fr_rotor.STL

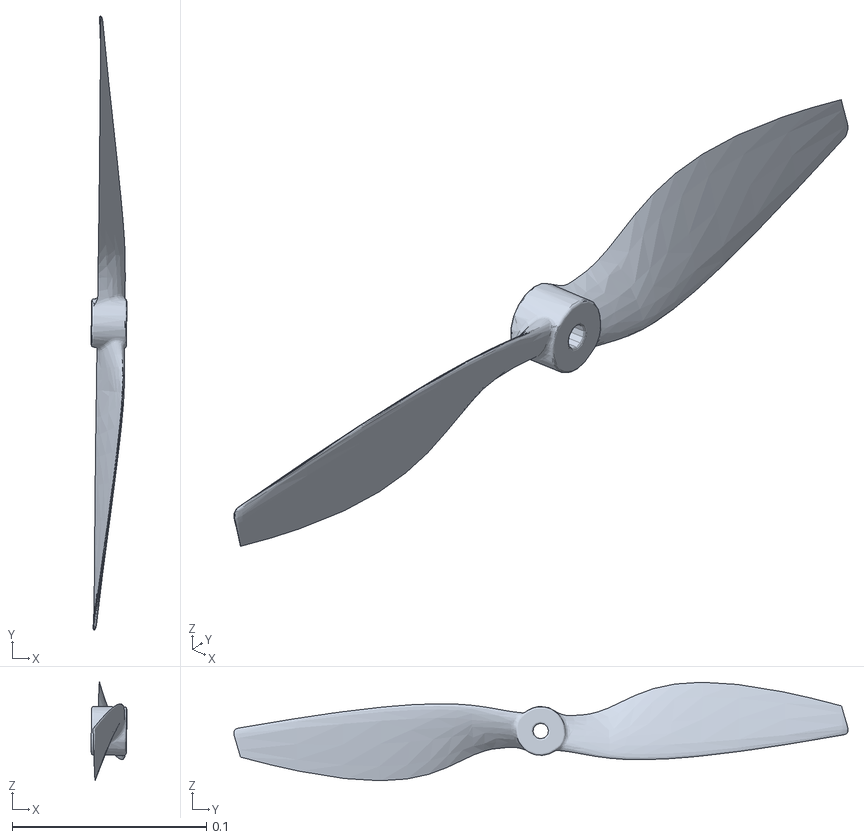
[picture p71: CAD file, 2026-09-01]
urdf/meshes/fr_rotor.STL
0.0183 x 0.316 x 0.0506
