hrx2025lucky-lab/flyarm-aerial-manipulation/assets_3d/3d打印零件/夹爪装配体 - 夹爪支架-1.STL

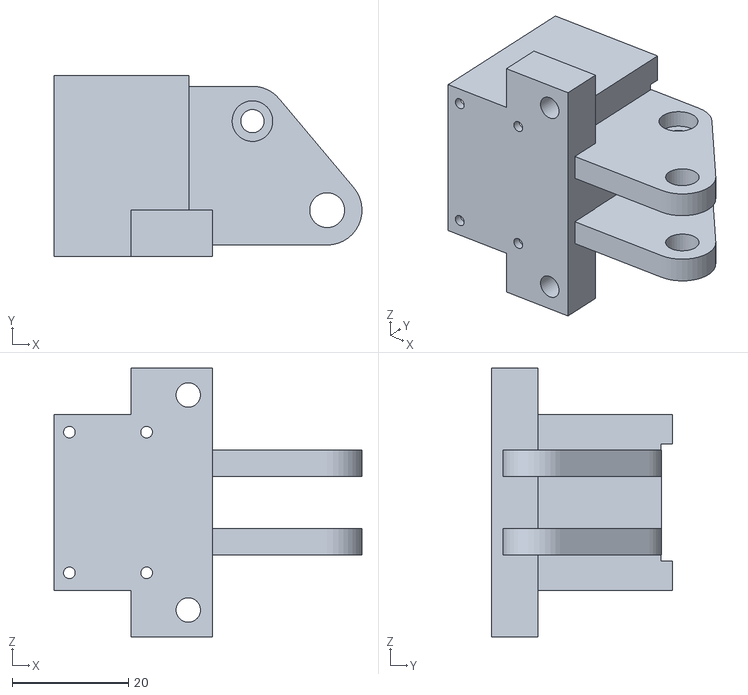
[picture p72: CAD file, 2026-09-01]
assets_3d/3d打印零件/夹爪装配体 - 夹爪支架-1.STL
53.0 x 31.2 x 46.2
