hrx2025lucky-lab/flyarm-aerial-manipulation/assets_3d/平行夹爪机械臂/舵机单臂舵盘渲染2018.SLDPRT

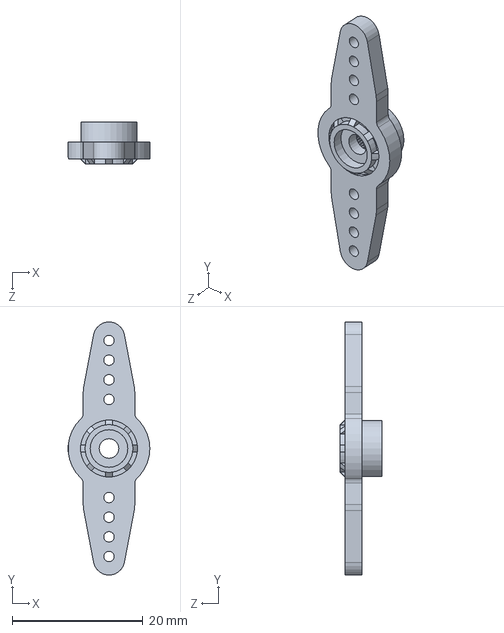
[picture p73: CAD file, 2026-09-01]
assets_3d/平行夹爪机械臂/舵机单臂舵盘渲染2018.SLDPRT
12.5 x 38.7 x 6.35 mm
