hrx2025lucky-lab/flyarm-aerial-manipulation/assets_3d/旋转夹爪机械臂/易格斯轴承GFM-0506-05 2018.SLDPRT

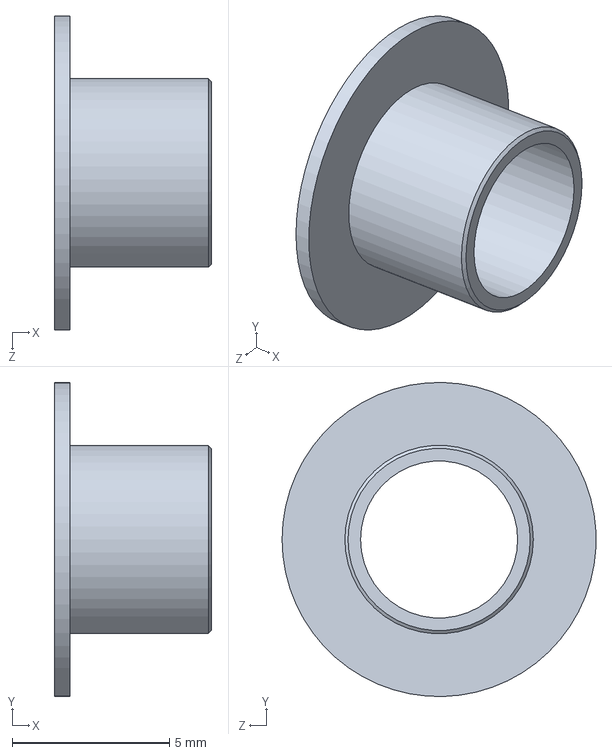
[picture p74: CAD file, 2026-09-01]
assets_3d/旋转夹爪机械臂/易格斯轴承GFM-0506-05 2018.SLDPRT
5.00 x 10.00 x 9.99 mm
