hrx2025lucky-lab/flyarm-aerial-manipulation/assets_3d/3d打印零件/上从动齿直齿M1X37.STL

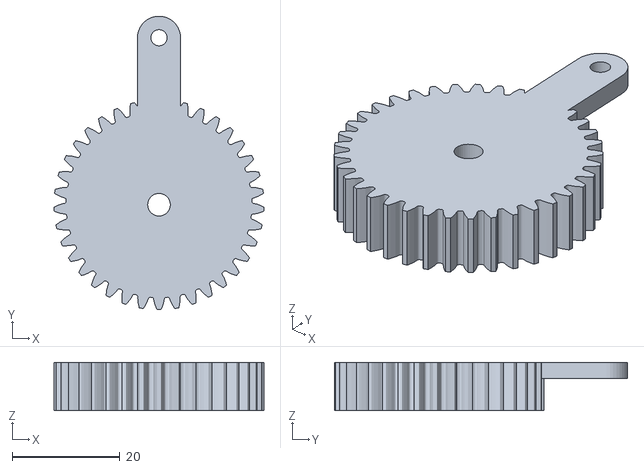
[picture p75: CAD file, 2026-09-01]
assets_3d/3d打印零件/上从动齿直齿M1X37.STL
39.0 x 54.5 x 9.00
