hrx2025lucky-lab/flyarm-aerial-manipulation/assets_3d/平行夹爪机械臂/￠4×M3×30 轴肩螺丝 2018.SLDPRT

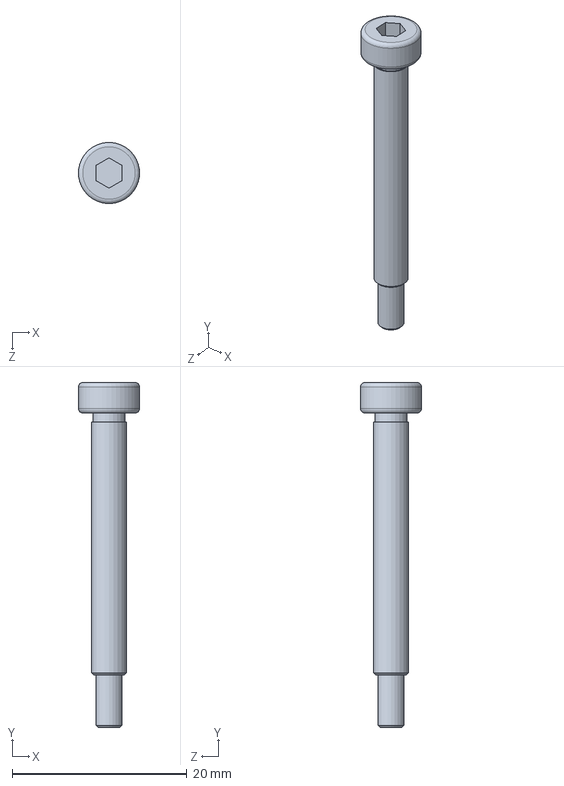
[picture p76: CAD file, 2026-09-01]
assets_3d/平行夹爪机械臂/￠4×M3×30 轴肩螺丝 2018.SLDPRT
7.00 x 39.5 x 6.98 mm
