hrx2025lucky-lab/flyarm-aerial-manipulation/assets_3d/3d打印零件/夹爪装配体 - HX-12H舵机装配体-1 HX-12H舵机-1.STL

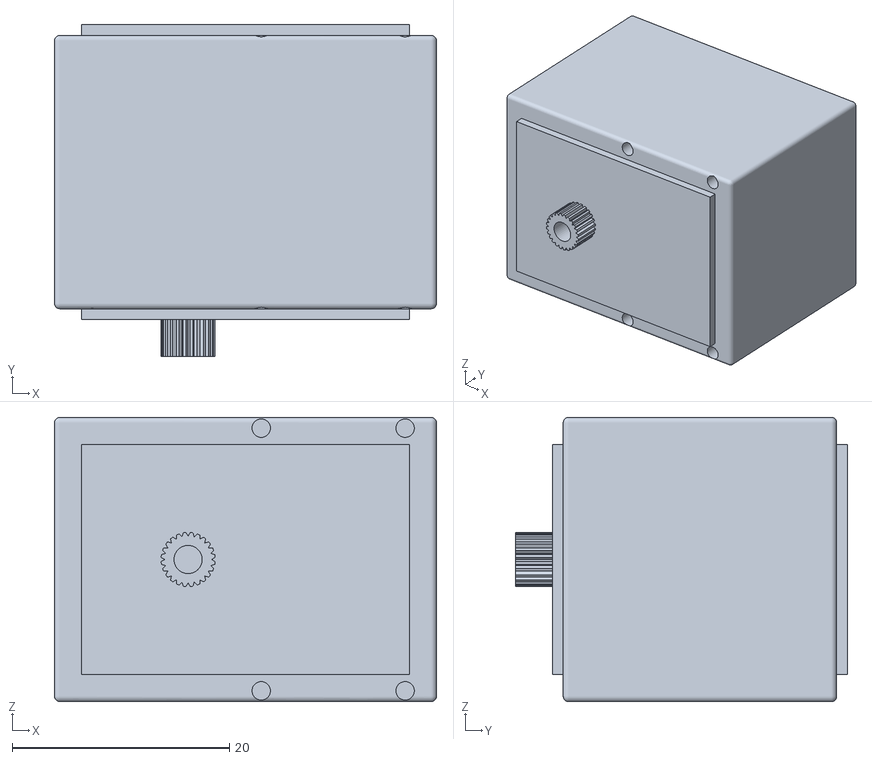
[picture p77: CAD file, 2026-09-01]
assets_3d/3d打印零件/夹爪装配体 - HX-12H舵机装配体-1 HX-12H舵机-1.STL
35.2 x 30.6 x 26.2
