hrx2025lucky-lab/flyarm-aerial-manipulation/assets_3d/平行夹爪机械臂/一字槽塞打螺钉 M4×25 2018.SLDPRT

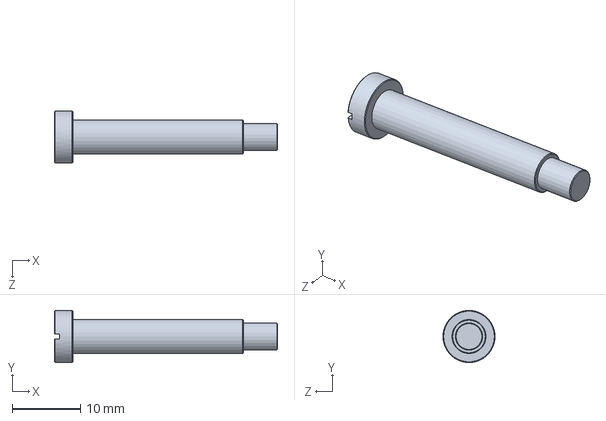
[picture p78: CAD file, 2026-09-01]
assets_3d/平行夹爪机械臂/一字槽塞打螺钉 M4×25 2018.SLDPRT
32.7 x 7.64 x 7.64 mm
