hrx2025lucky-lab/flyarm-aerial-manipulation/assets_3d/平行夹爪机械臂/GB845-1985十字槽盘头自攻螺钉-C型ST2．9×13.SLDPRT

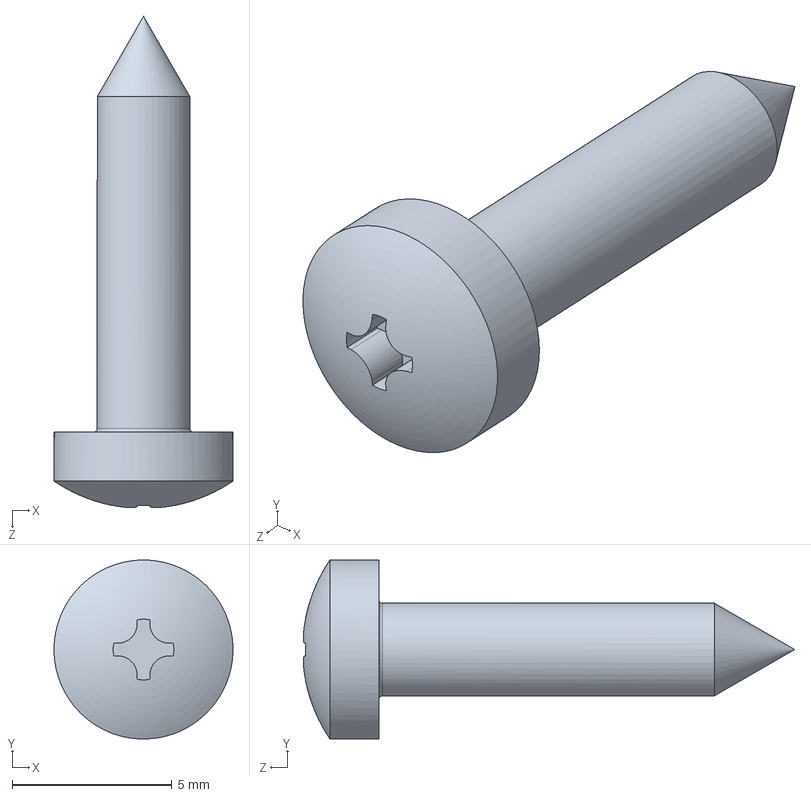
[picture p79: CAD file, 2026-09-01]
assets_3d/平行夹爪机械臂/GB845-1985十字槽盘头自攻螺钉-C型ST2．9×13.SLDPRT
5.60 x 5.60 x 15.4 mm
