hrx2025lucky-lab/flyarm-aerial-manipulation/assets_3d/3d打印零件/HTPA72S3M060_A_H8_b.STL

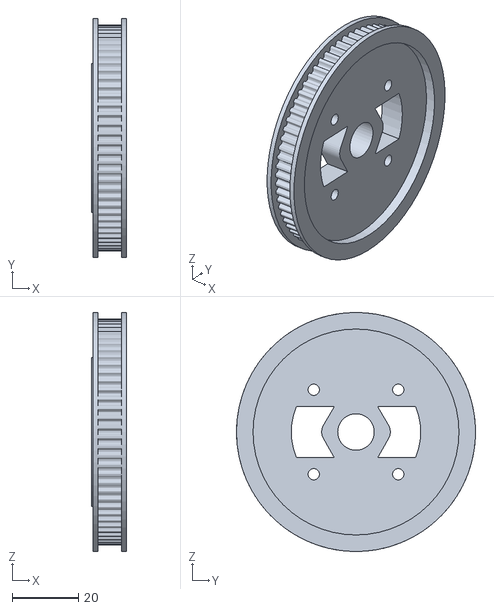
[picture p80: CAD file, 2026-09-01]
assets_3d/3d打印零件/HTPA72S3M060_A_H8_b.STL
10.5 x 72.0 x 72.0
