hrx2025lucky-lab/flyarm-aerial-manipulation/assets_3d/平行夹爪机械臂/直径5长55光轴.SLDPRT

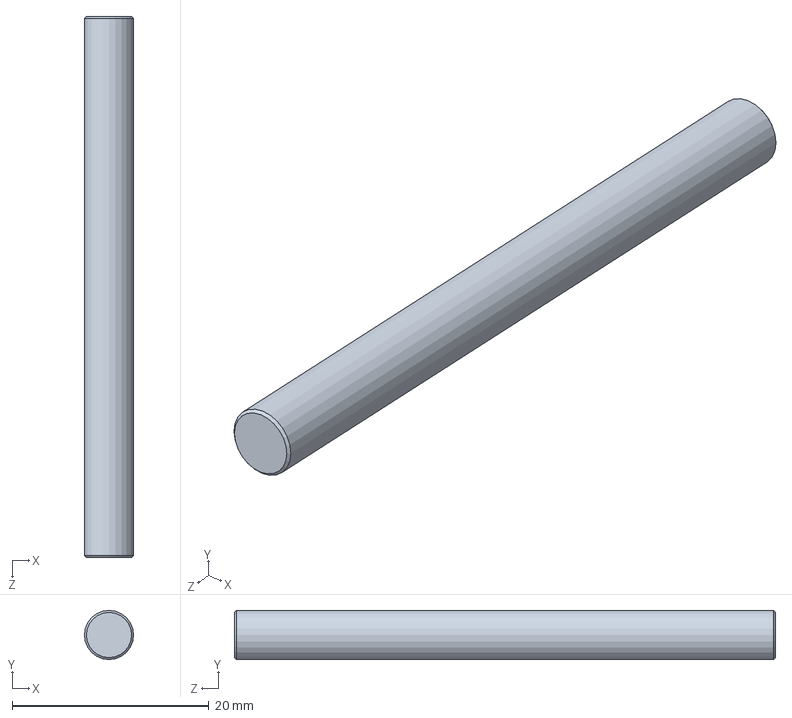
[picture p81: CAD file, 2026-09-01]
assets_3d/平行夹爪机械臂/直径5长55光轴.SLDPRT
5.00 x 5.00 x 55.0 mm
