hrx2025lucky-lab/flyarm-aerial-manipulation/assets_3d/旋转夹爪机械臂/GB／T276-94深沟球轴承619／5.SLDPRT

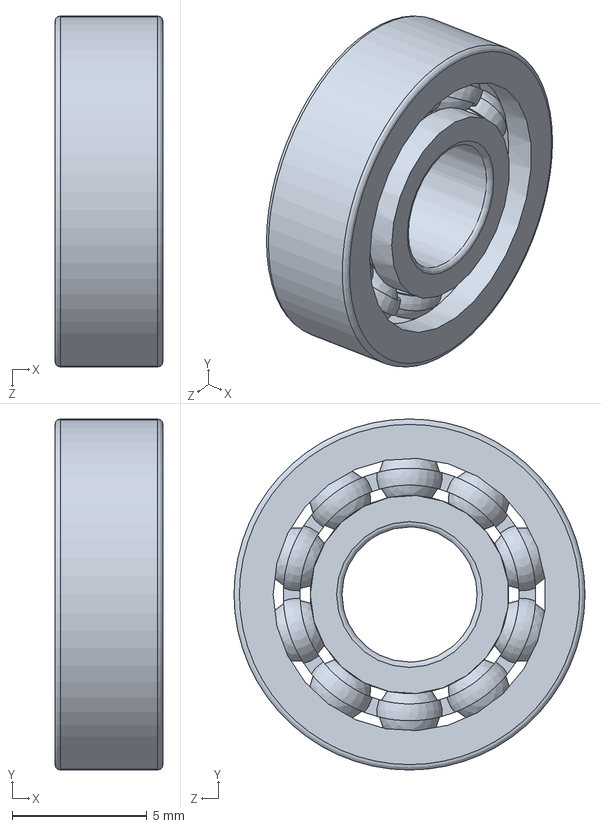
[picture p82: CAD file, 2026-09-01]
assets_3d/旋转夹爪机械臂/GB／T276-94深沟球轴承619／5.SLDPRT
4.00 x 13.0 x 13.0 mm
