hrx2025lucky-lab/flyarm-aerial-manipulation/assets_3d/空中机械臂/脚架管1-伸长.SLDPRT

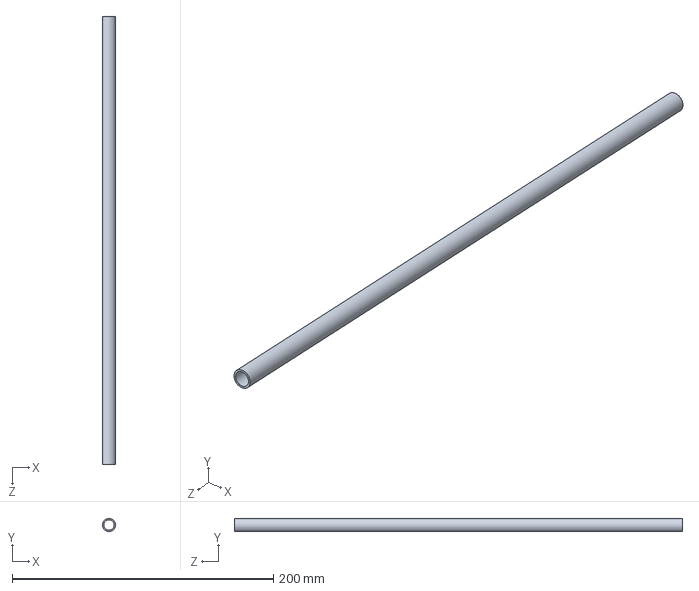
[picture p83: CAD file, 2026-09-01]
assets_3d/空中机械臂/脚架管1-伸长.SLDPRT
10.0 x 9.95 x 343.0 mm
