hrx2025lucky-lab/flyarm-aerial-manipulation/assets_3d/3d打印零件/夹爪装配体 - pin1-3.STL

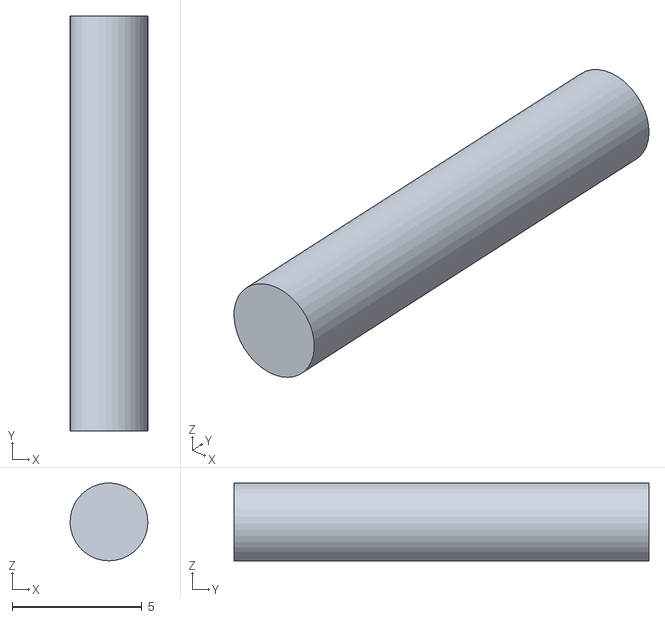
[picture p84: CAD file, 2026-09-01]
assets_3d/3d打印零件/夹爪装配体 - pin1-3.STL
3.00 x 16.0 x 3.00
