hrx2025lucky-lab/flyarm-aerial-manipulation/assets_3d/平行夹爪机械臂/方案-固定底座.SLDPRT

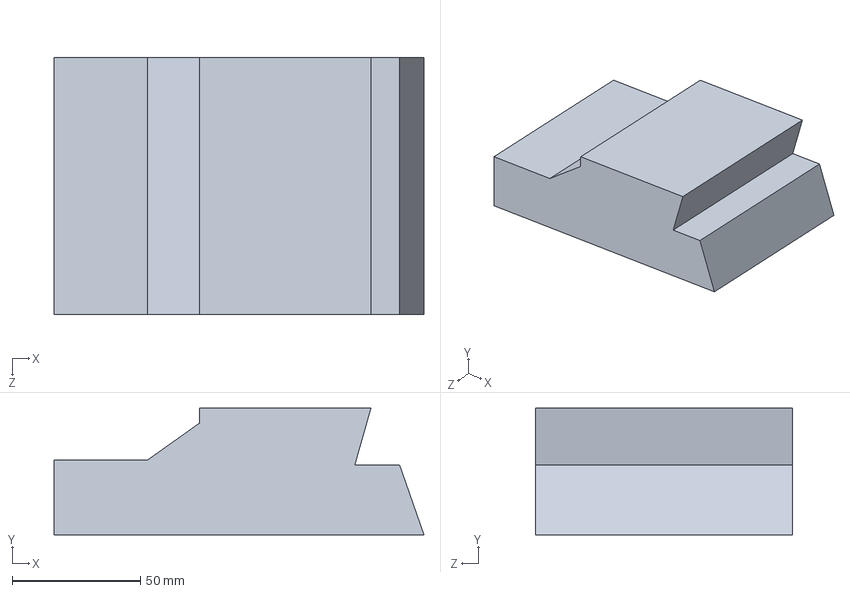
[picture p85: CAD file, 2026-09-01]
assets_3d/平行夹爪机械臂/方案-固定底座.SLDPRT
144.0 x 49.3 x 100.0 mm
