hrx2025lucky-lab/flyarm-aerial-manipulation/assets_3d/旋转夹爪机械臂/下深沟球轴承61900.SLDPRT

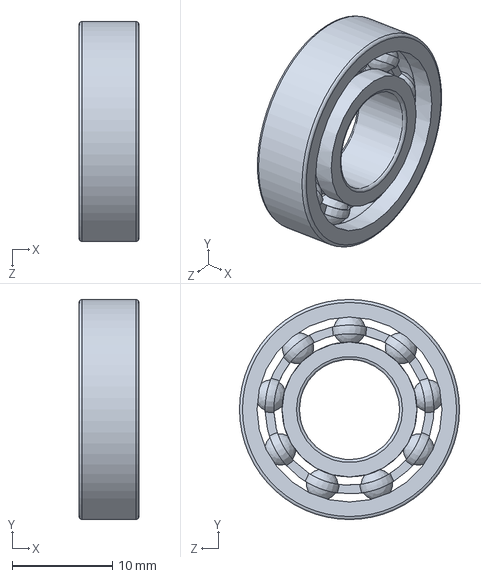
[picture p86: CAD file, 2026-09-01]
assets_3d/旋转夹爪机械臂/下深沟球轴承61900.SLDPRT
6.00 x 22.0 x 22.0 mm
