hrx2025lucky-lab/flyarm-aerial-manipulation/assets_3d/平行夹爪机械臂/旋转底座.SLDPRT

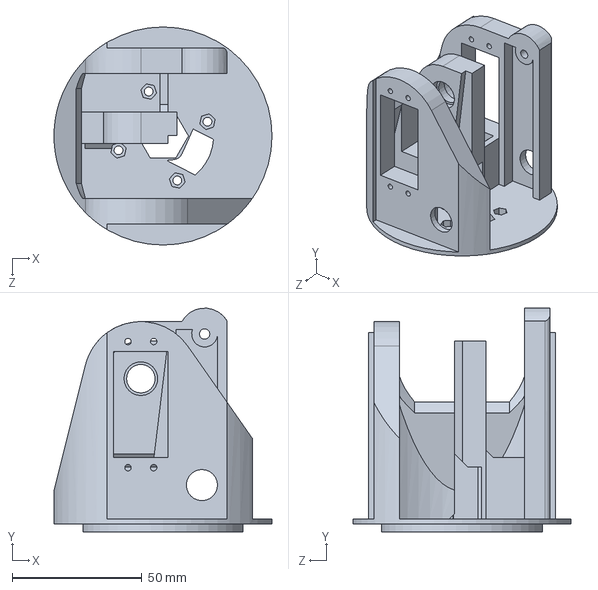
[picture p88: CAD file, 2026-09-01]
assets_3d/平行夹爪机械臂/旋转底座.SLDPRT
84.0 x 86.2 x 84.0 mm
