hrx2025lucky-lab/flyarm-aerial-manipulation/assets_3d/旋转夹爪机械臂/B2C轴连杆.SLDPRT

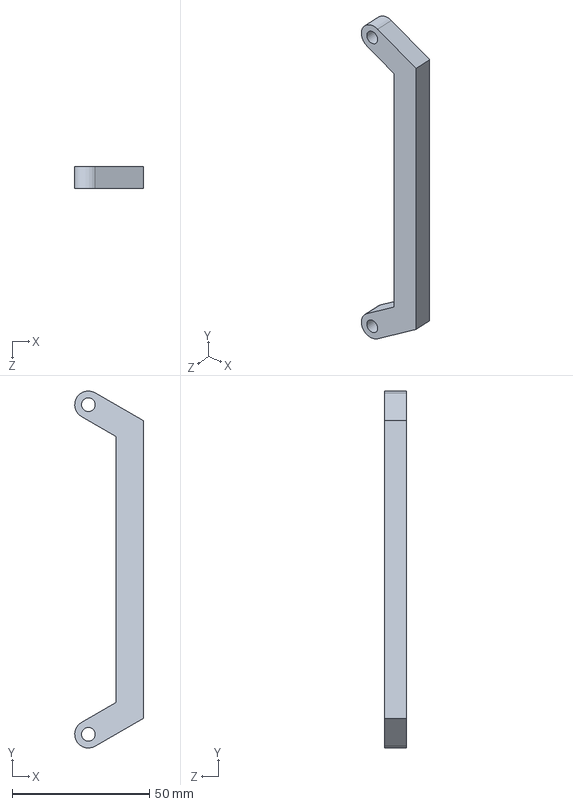
[picture p89: CAD file, 2026-09-01]
assets_3d/旋转夹爪机械臂/B2C轴连杆.SLDPRT
25.0 x 130.0 x 8.00 mm
