hrx2025lucky-lab/flyarm-aerial-manipulation/assets_3d/平行夹爪机械臂/GB／T70．1-2000内六角圆柱头螺钉M10×50.SLDPRT

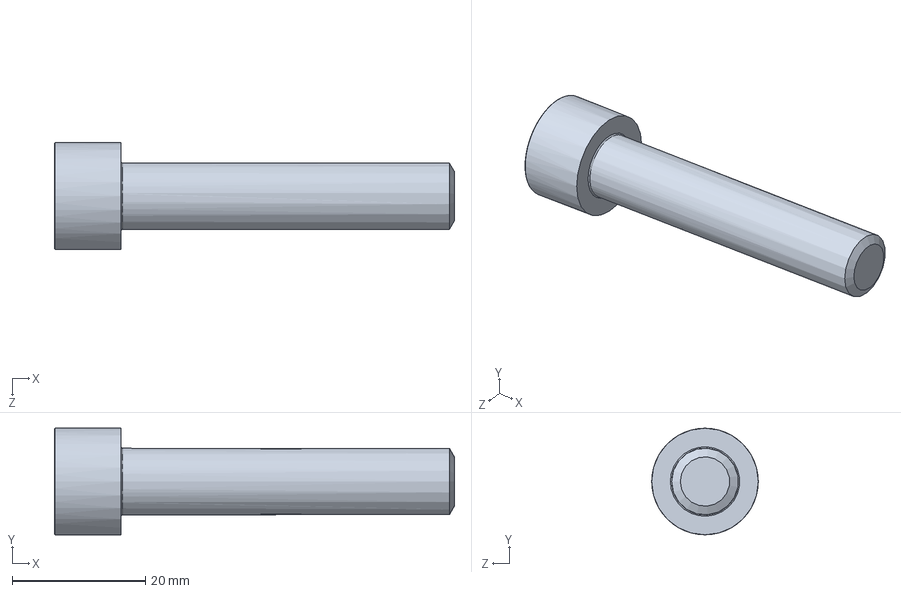
[picture p90: CAD file, 2026-09-01]
assets_3d/平行夹爪机械臂/GB／T70．1-2000内六角圆柱头螺钉M10×50.SLDPRT
60.0 x 16.0 x 16.0 mm
