hrx2025lucky-lab/flyarm-aerial-manipulation/assets_3d/旋转夹爪机械臂/CD轴连杆.SLDPRT

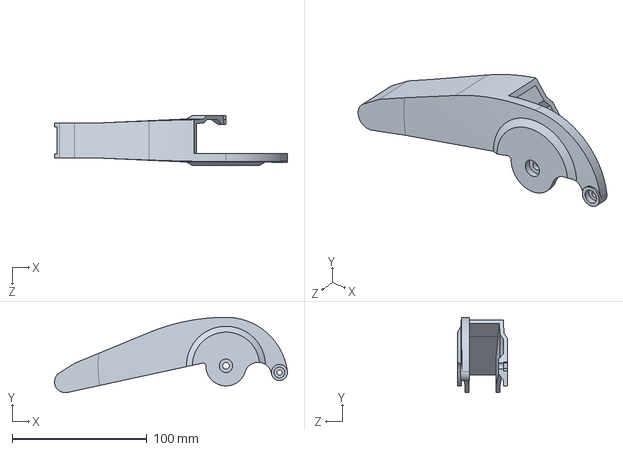
[picture p91: CAD file, 2026-09-01]
assets_3d/旋转夹爪机械臂/CD轴连杆.SLDPRT
173.1 x 56.0 x 37.0 mm
