hrx2025lucky-lab/flyarm-aerial-manipulation/assets_3d/3d打印零件/夹爪装配体 - 舵机圆舵盘渲染2018-1.STL

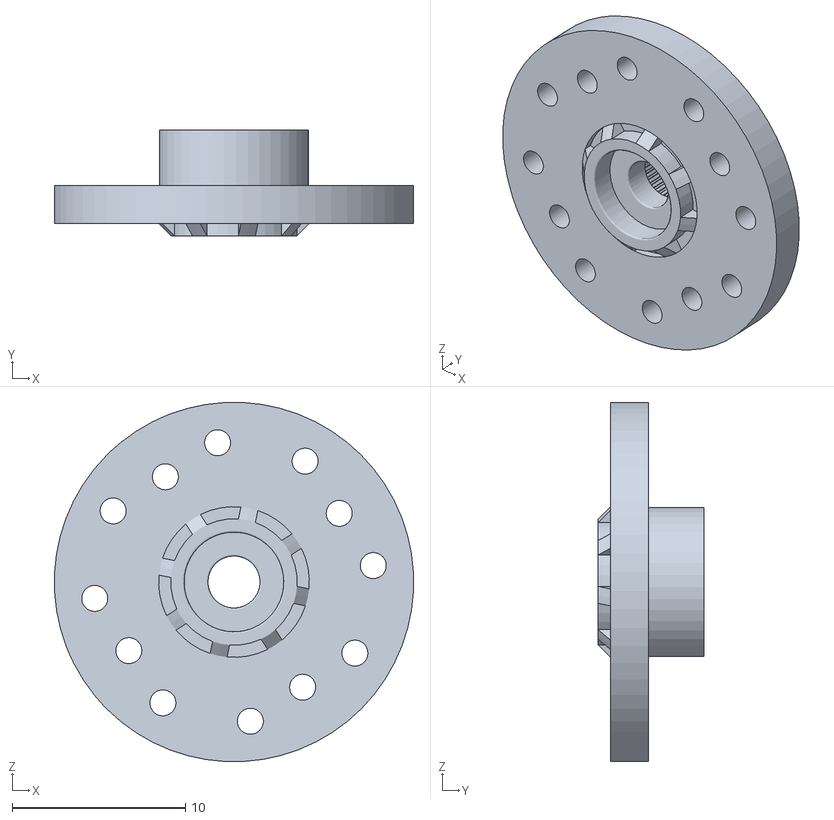
[picture p92: CAD file, 2026-09-01]
assets_3d/3d打印零件/夹爪装配体 - 舵机圆舵盘渲染2018-1.STL
20.7 x 6.10 x 20.7
