hrx2025lucky-lab/flyarm-aerial-manipulation/assets_3d/平行夹爪机械臂/B2轴摇杆.SLDPRT

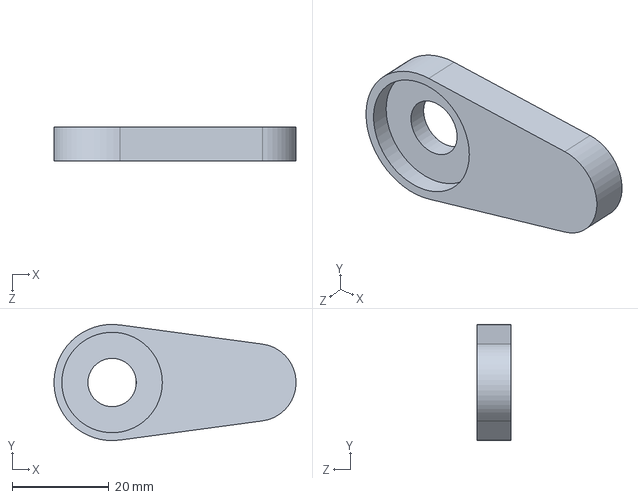
[picture p93: CAD file, 2026-09-01]
assets_3d/平行夹爪机械臂/B2轴摇杆.SLDPRT
50.0 x 24.0 x 7.00 mm
