hrx2025lucky-lab/flyarm-aerial-manipulation/assets_3d/旋转夹爪机械臂/下水平连杆.SLDPRT

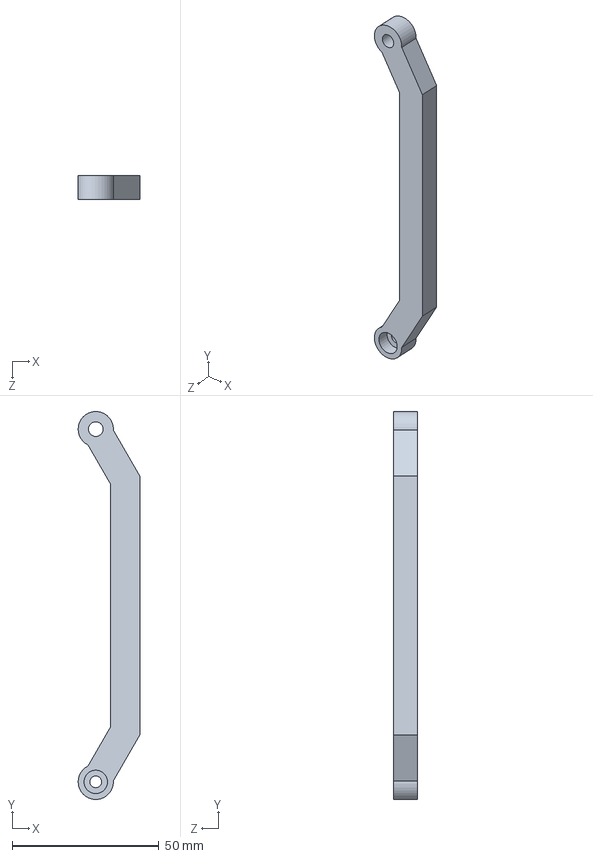
[picture p94: CAD file, 2026-09-01]
assets_3d/旋转夹爪机械臂/下水平连杆.SLDPRT
21.0 x 132.0 x 8.00 mm
