hrx2025lucky-lab/flyarm-aerial-manipulation/assets_3d/旋转夹爪机械臂/b轴摇杆.SLDPRT

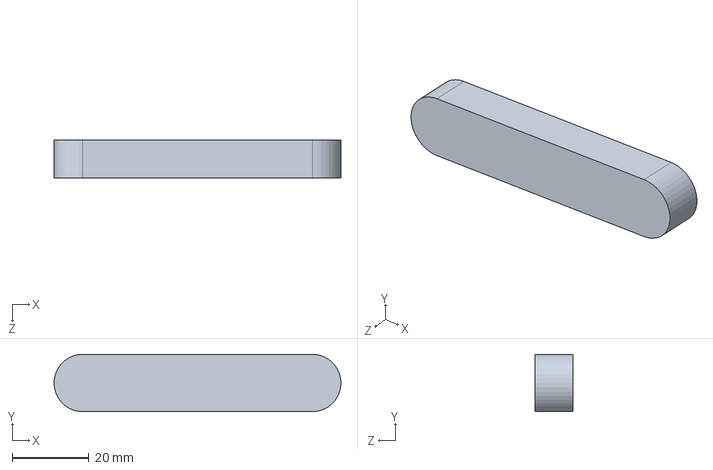
[picture p95: CAD file, 2026-09-01]
assets_3d/旋转夹爪机械臂/b轴摇杆.SLDPRT
75.0 x 15.0 x 10.0 mm
