hrx2025lucky-lab/flyarm-aerial-manipulation/assets_3d/旋转夹爪机械臂/cd连杆2.SLDPRT

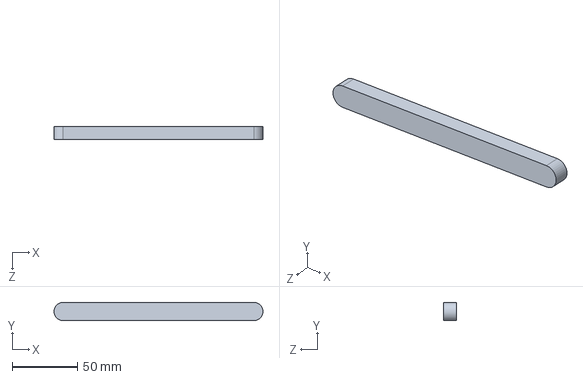
[picture p96: CAD file, 2026-09-01]
assets_3d/旋转夹爪机械臂/cd连杆2.SLDPRT
159.8 x 13.9 x 10.0 mm
