hrx2025lucky-lab/flyarm-aerial-manipulation/assets_3d/3d打印零件/夹爪装配体 - 夹爪臂-2.STL

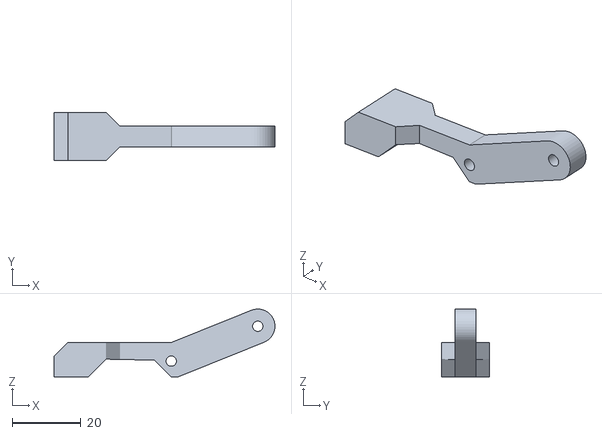
[picture p97: CAD file, 2026-09-01]
assets_3d/3d打印零件/夹爪装配体 - 夹爪臂-2.STL
64.2 x 14.0 x 19.7
