hrx2025lucky-lab/flyarm-aerial-manipulation/assets_3d/旋转夹爪机械臂/HTBN264S3M_60_info_1_28_72.SLDPRT

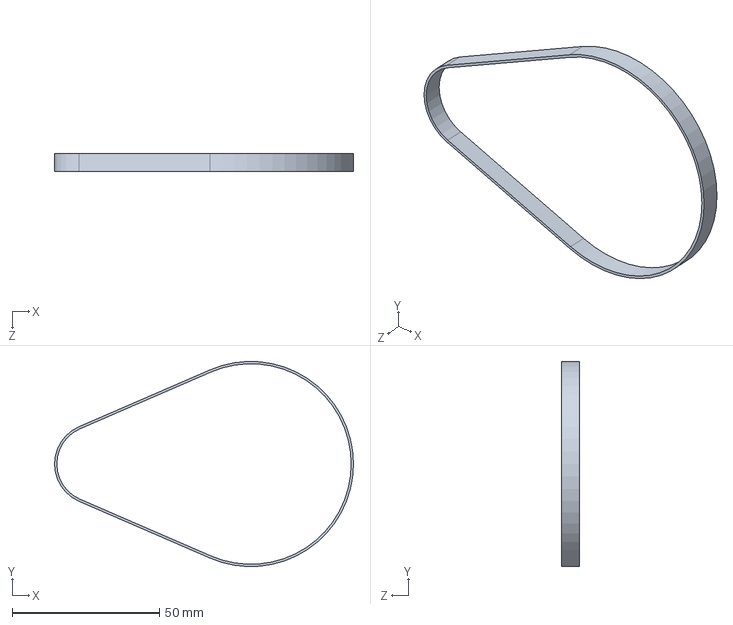
[picture p98: CAD file, 2026-09-01]
assets_3d/旋转夹爪机械臂/HTBN264S3M_60_info_1_28_72.SLDPRT
101.4 x 69.5 x 6.00 mm
