hrx2025lucky-lab/flyarm-aerial-manipulation/assets_3d/3d打印零件/B2轴摇杆.STL

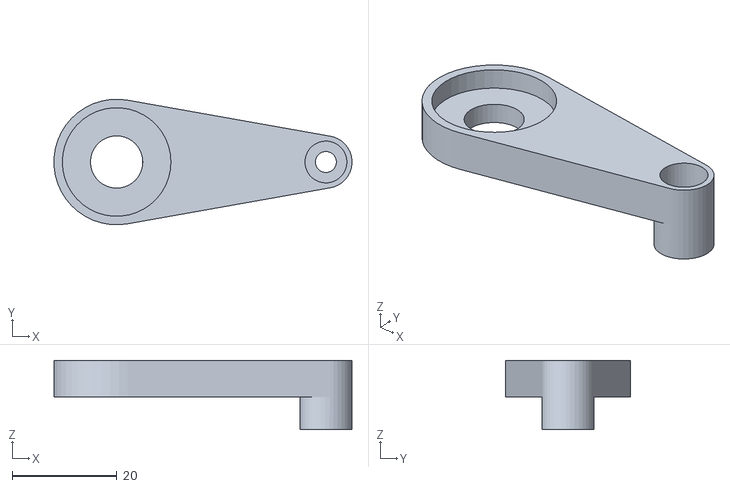
[picture p99: CAD file, 2026-09-01]
assets_3d/3d打印零件/B2轴摇杆.STL
57.0 x 24.0 x 13.2
