hrx2025lucky-lab/flyarm-aerial-manipulation/assets_3d/旋转夹爪机械臂/夹爪臂.SLDPRT

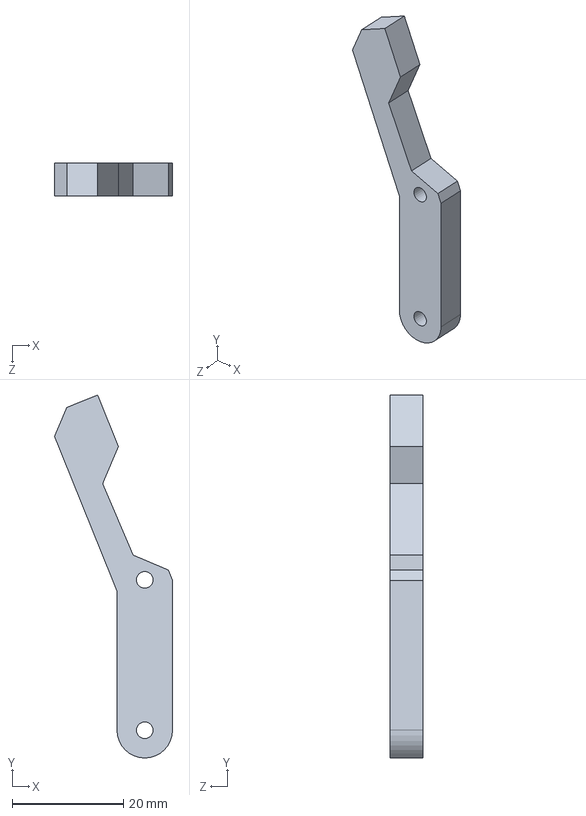
[picture p100: CAD file, 2026-09-01]
assets_3d/旋转夹爪机械臂/夹爪臂.SLDPRT
21.3 x 65.4 x 6.00 mm
