hrx2025lucky-lab/flyarm-aerial-manipulation/assets_3d/3d打印零件/直齿M1X29.STL

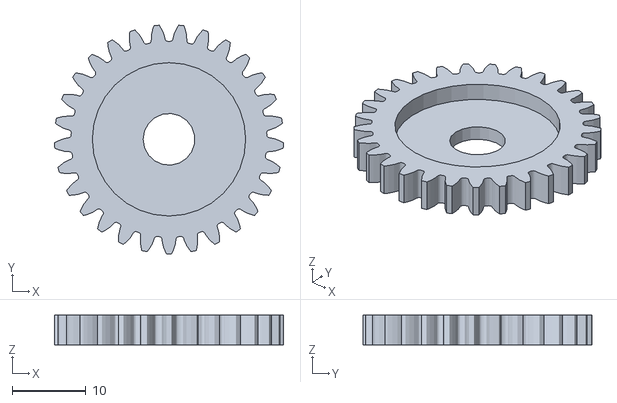
[picture p101: CAD file, 2026-09-01]
assets_3d/3d打印零件/直齿M1X29.STL
31.0 x 30.9 x 4.00
