hrx2025lucky-lab/flyarm-aerial-manipulation/assets_3d/平行夹爪机械臂/下从动齿直齿M1X37B.SLDPRT

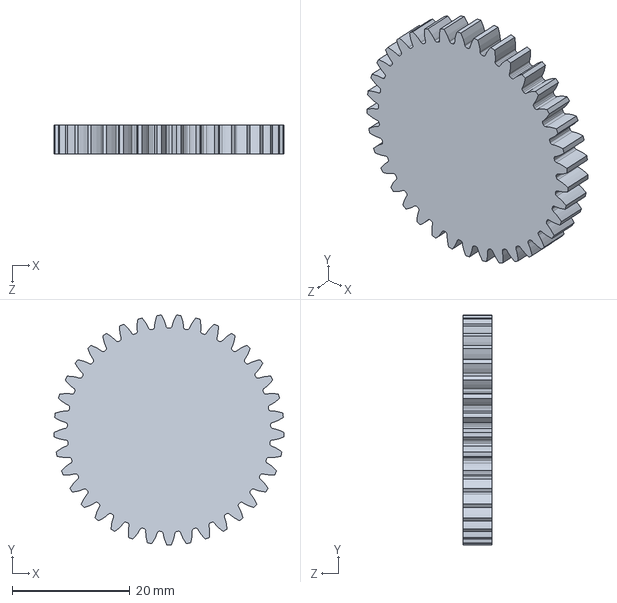
[picture p102: CAD file, 2026-09-01]
assets_3d/平行夹爪机械臂/下从动齿直齿M1X37B.SLDPRT
39.0 x 39.0 x 5.00 mm
