hrx2025lucky-lab/flyarm-aerial-manipulation/assets_3d/3d打印零件/夹爪臂.STL

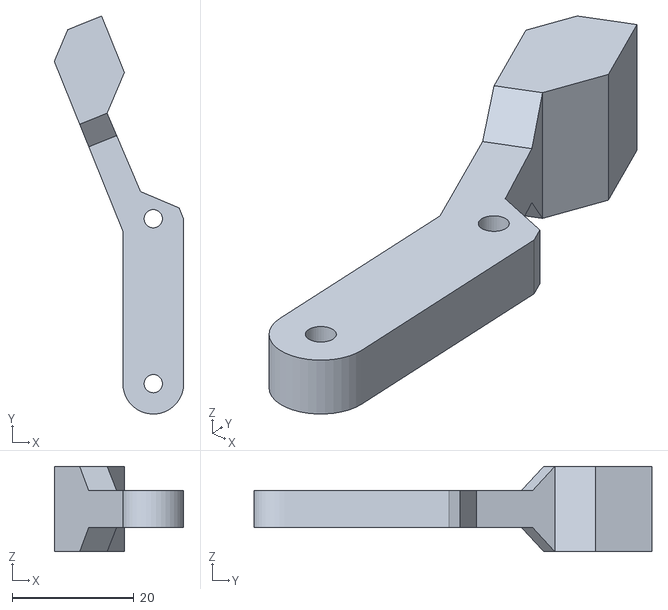
[picture p104: CAD file, 2026-09-01]
assets_3d/3d打印零件/夹爪臂.STL
21.3 x 65.4 x 14.0
