hrx2025lucky-lab/flyarm-aerial-manipulation/assets_3d/平行夹爪机械臂/大舵机装配体[阿奇设计分享提供]2018.SLDASM

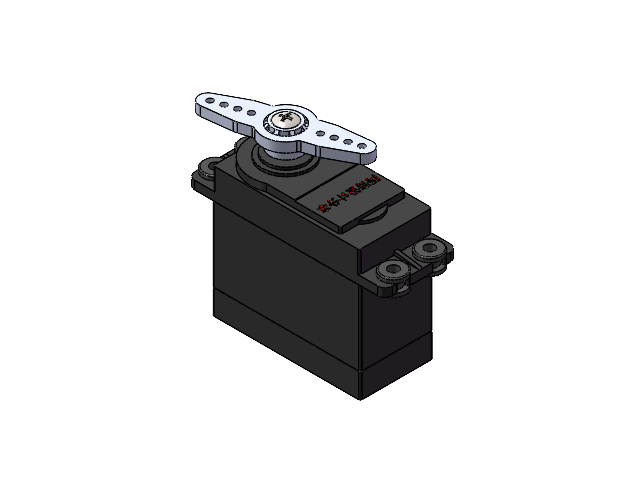
[picture p105: CAD file, 2026-09-01]
assets_3d/平行夹爪机械臂/大舵机装配体[阿奇设计分享提供]2018.SLDASM
大舵机渲染2018
舵机橡胶圈渲染2018 x 4
舵机单臂舵盘渲染2018
cross recessed pan head screws gb(GB_CROSS_SCREWS_TYPE1 M3X6-6 H type-N)2018
