hrx2025lucky-lab/flyarm-aerial-manipulation/assets_3d/平行夹爪机械臂/夹爪装配体.SLDASM

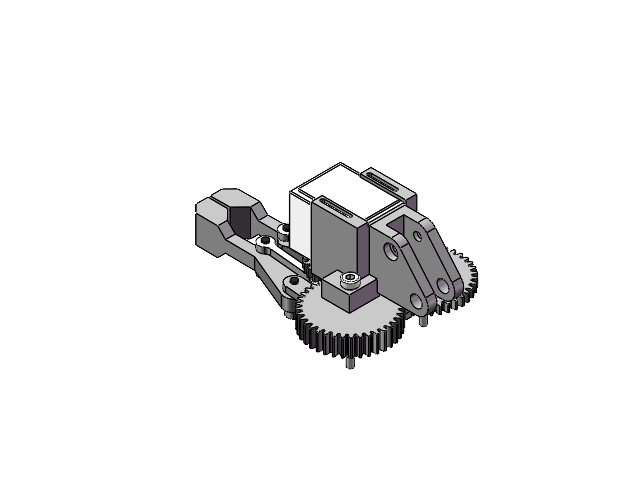
[picture p106: CAD file, 2026-09-01]
assets_3d/平行夹爪机械臂/夹爪装配体.SLDASM
￠4×M3×30 轴肩螺丝 2018 x 2
舵机圆舵盘渲染2018
主动齿直齿M1X24
上从动齿直齿M1X37
下从动齿直齿M1X37B
pin1 x 6
夹爪连接件
grip part 3 x 4
夹爪臂 x 2
从动齿轮轴下连杆 x 2
