hrx2025lucky-lab/flyarm-aerial-manipulation/assets_3d/旋转夹爪机械臂/固定底座装配体.SLDASM

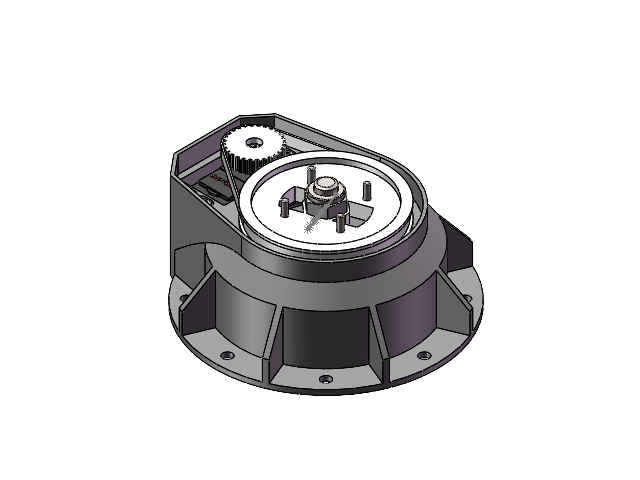
[picture p107: CAD file, 2026-09-01]
assets_3d/旋转夹爪机械臂/固定底座装配体.SLDASM
固定底座
下深沟球轴承61900
上深沟球轴承61809
大舵机渲染2018
舵机橡胶圈渲染2018 x 4
舵机圆舵盘渲染2018
cross recessed pan head screws gb(GB_CROSS_SCREWS_TYPE1 M3X6-6 H type-N)2018
HTPA28S3M060_A_H5_b
HTPA72S3M060_A_H8_b
HTBN264S3M_60_info_1_28_72
GB／T889．2-20001型非金属嵌件六角锁紧螺母细牙M10
GB／T70．1-2000内六角圆柱头螺钉M10×50
GB／T70．1-2000内六角圆柱头螺钉M3×12 x 8
GB／T6172．2-2000非金属嵌件六角锁紧薄螺母3 x 4
