hrx2025lucky-lab/flyarm-aerial-manipulation/assets_3d/空中机械臂/机械臂四轴无人机.SLDASM

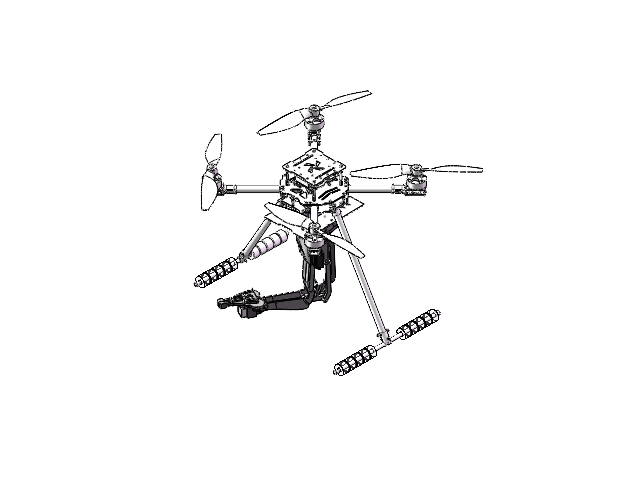
[picture p108: CAD file, 2026-09-01]
assets_3d/空中机械臂/机械臂四轴无人机.SLDASM
中心板下
机臂碳管 x 4
电机座 管夹 x 4
电机座板 x 8
12 铝柱 x 8
HM3.0x6螺丝 x 35
HM3.0x10螺丝 x 76
40 铝柱 x 4
电池板
脚架连接件 x 2
脚架管1
脚架管2 x 2
HM3.0x8螺丝 x 4
M3螺母 x 6
HM3.0x20螺丝 x 2
脚架座 x 2
脚架管1-伸长
脚架管塞 x 4
海绵套管 x 4
4112 KV400 x 4
12寸反桨 x 4
铜柱21.6 x 6
中心板下 - 副本
机臂夹 x 2
机臂夹1 x 2
M3螺母1 x 8
电池板1
PIXHAWK
减震橡胶 x 4
碳板上上
电池
opensource_arm小圆盘
铜柱50 x 4
零件1^机械臂四轴无人机
支撑螺柱 x 8
固定底座
下深沟球轴承61900
上深沟球轴承61809
大舵机渲染2018 x 3
舵机橡胶圈渲染2018 x 12
舵机圆舵盘渲染2018 x 4
cross recessed pan head screws gb(GB_CROSS_SCREWS_TYPE1 M3X6-6 H type-N)2018 x 3
HTPA28S3M060_A_H5_b
HTPA72S3M060_A_H8_b
HTBN264S3M_60_info_1_28_72
GB／T889．2-20001型非金属嵌件六角锁紧螺母细牙M10
GB／T70．1-2000内六角圆柱头螺钉M10×50
GB／T70．1-2000内六角圆柱头螺钉M3×12 x 8
GB／T6172．2-2000非金属嵌件六角锁紧薄螺母3 x 14
旋转底座
B2轴摇杆
5×M4×20 轴肩螺丝2018
GB／T276-94深沟球轴承619／5 x 2
B1C连杆
GB／T6172．2-2000非金属嵌件六角锁紧薄螺母4 x 3
CD轴连杆
易格斯轴承GFM-0506-05 2018 x 6
￠5×M4×30 轴肩螺丝渲染 2018
三角形连杆
夹爪支架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
