hrx2025lucky-lab/flyarm-aerial-manipulation/assets_3d/旋转夹爪机械臂/方案-机械臂装配体.SLDASM

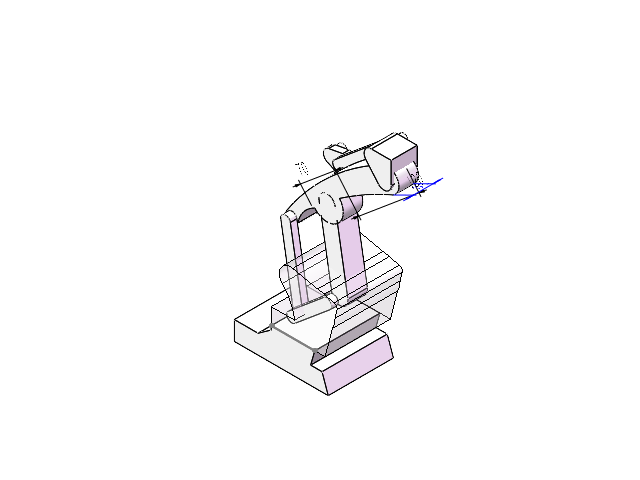
[picture p109: CAD file, 2026-09-01]
assets_3d/旋转夹爪机械臂/方案-机械臂装配体.SLDASM
方案-固定底座
方案-旋转底座
bc连杆
cd连杆
b轴摇杆
b轴摇杆连杆
d轴支架
cd连杆2
三角连接件
b轴摇杆连杆2
