hrx2025lucky-lab/flyarm-aerial-manipulation/assets_3d/平行夹爪机械臂/装配体MG10.SLDASM

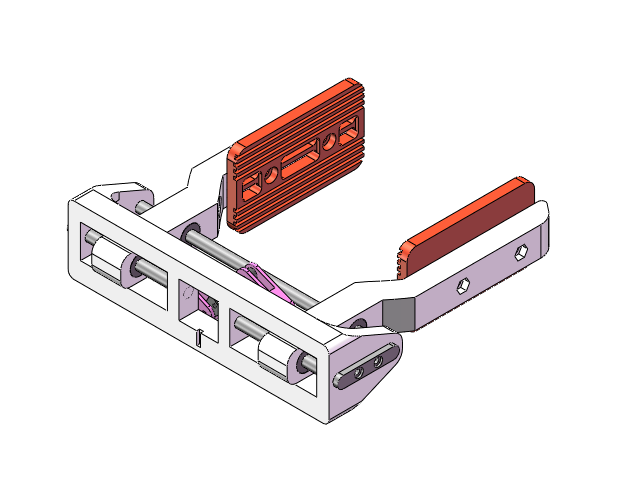
[picture p110: CAD file, 2026-09-01]
assets_3d/平行夹爪机械臂/装配体MG10.SLDASM
MG10基体
滚珠轴承 x 4
爪1 x 2
舵机臂
长拉杆 x 2
直径5长55光轴 x 2
直径5长135光轴
限位盖 x 2
末端爪1 x 2
内径3mm外径5mm厚4mm轴套 x 2
