hrx2025lucky-lab/flyarm-aerial-manipulation/assets_3d/平行夹爪机械臂/旋转底座装配体.SLDASM

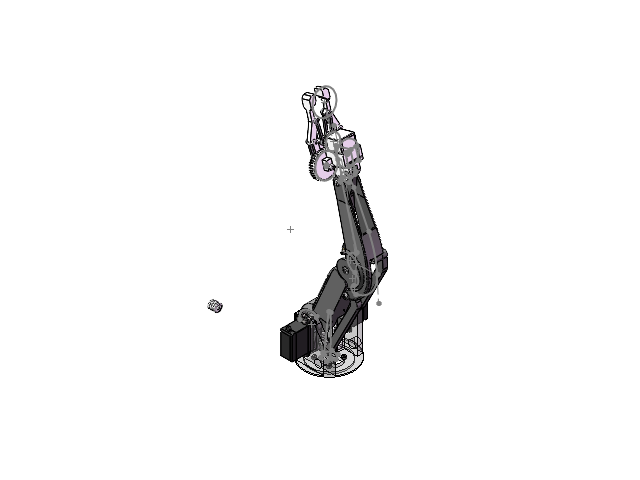
[picture p111: CAD file, 2026-09-01]
assets_3d/平行夹爪机械臂/旋转底座装配体.SLDASM
旋转底座
大舵机渲染2018 x 2
舵机橡胶圈渲染2018 x 8
舵机圆舵盘渲染2018 x 2
cross recessed pan head screws gb(GB_CROSS_SCREWS_TYPE1 M3X6-6 H type-N)2018 x 2
B2轴摇杆
5×M4×20 轴肩螺丝2018
GB／T276-94深沟球轴承619／5 x 2
B1C连杆
GB／T6172．2-2000非金属嵌件六角锁紧薄螺母4 x 3
CD轴连杆
易格斯轴承GFM-0506-05 2018 x 6
￠5×M4×30 轴肩螺丝渲染 2018
三角形连杆
上水平连杆
易格斯轴承GFM-04050-04 2018 x 12
￠4×M3×12 轴肩螺丝 2018 x 5
GB／T6172．2-2000非金属嵌件六角锁紧薄螺母3 x 10
下水平连杆
B2C轴连杆
一字槽塞打螺钉 M3×12 2018
一字槽塞打螺钉 M4×25 2018
GB845-1985十字槽盘头自攻螺钉-C型ST2．9×13 x 8
