hrx2025lucky-lab/flyarm-aerial-manipulation/assets_3d/旋转夹爪机械臂/HX-12H舵机装配体.SLDASM

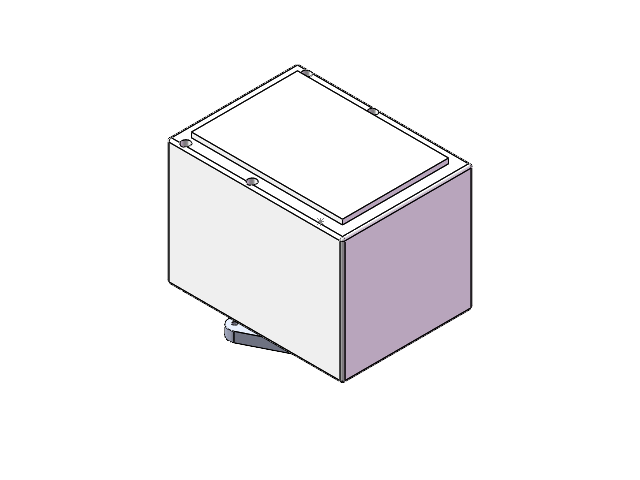
[picture p113: CAD file, 2026-09-01]
assets_3d/旋转夹爪机械臂/HX-12H舵机装配体.SLDASM
HX-12H舵机
cross recessed pan head screws gb(GB_CROSS_SCREWS_TYPE1 M2X4-4 H type-N)2018
MG90S 金属舵机单舵臂渲染2018
