hrx2025lucky-lab/flyarm-aerial-manipulation/assets_3d/旋转夹爪机械臂/机械臂总装配体.SLDASM

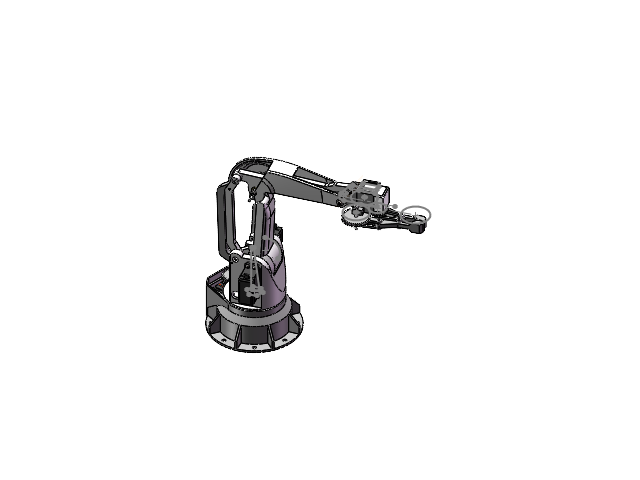
[picture p114: CAD file, 2026-09-01]
assets_3d/旋转夹爪机械臂/机械臂总装配体.SLDASM
固定底座
下深沟球轴承61900
上深沟球轴承61809
大舵机渲染2018 x 3
舵机橡胶圈渲染2018 x 12
舵机圆舵盘渲染2018 x 4
cross recessed pan head screws gb(GB_CROSS_SCREWS_TYPE1 M3X6-6 H type-N)2018 x 3
HTPA28S3M060_A_H5_b
HTPA72S3M060_A_H8_b
HTBN264S3M_60_info_1_28_72
GB／T889．2-20001型非金属嵌件六角锁紧螺母细牙M10
GB／T70．1-2000内六角圆柱头螺钉M10×50
GB／T70．1-2000内六角圆柱头螺钉M3×12 x 8
GB／T6172．2-2000非金属嵌件六角锁紧薄螺母3 x 14
旋转底座
B2轴摇杆
5×M4×20 轴肩螺丝2018
GB／T276-94深沟球轴承619／5 x 2
B1C连杆
GB／T6172．2-2000非金属嵌件六角锁紧薄螺母4 x 3
CD轴连杆
易格斯轴承GFM-0506-05 2018 x 6
￠5×M4×30 轴肩螺丝渲染 2018
三角形连杆
夹爪支架
HX-12H舵机
￠4×M3×30 轴肩螺丝 2018 x 2
主动齿直齿M1X24
上从动齿直齿M1X37
下从动齿直齿M1X37B
pin1 x 6
夹爪连接件
grip part 3 x 4
夹爪臂 x 2
从动齿轮轴下连杆 x 2
上水平连杆
易格斯轴承GFM-04050-04 2018 x 12
￠4×M3×12 轴肩螺丝 2018 x 5
下水平连杆
B2C轴连杆
一字槽塞打螺钉 M3×12 2018
一字槽塞打螺钉 M4×25 2018
GB845-1985十字槽盘头自攻螺钉-C型ST2．9×13 x 8
