hrx2025lucky-lab/flyarm-aerial-manipulation/(list of files, cad)

Other CAD files:
assets_3d/旋转夹爪机械臂/3d打印零件.SLDASM
assets_3d/平行夹爪机械臂/固定底座装配体.SLDASM
assets_3d/旋转夹爪机械臂/夹爪装配体.SLDASM
assets_3d/平行夹爪机械臂/HX-12H舵机装配体.SLDASM
assets_3d/旋转夹爪机械臂/旋转底座装配体.SLDASM
assets_3d/空中机械臂/脚架座.sldprt
assets_3d/3d打印零件/夹爪装配体 - grip part 3-5.STL
assets_3d/空中机械臂/HM3.0x10螺丝.sldprt
assets_3d/空中机械臂/M3螺母.sldprt
urdf/meshes/parallel_gripper/pg_left_finger.STL
assets_3d/旋转夹爪机械臂/HTPA72S3M060_A_H8_b.SLDPRT
assets_3d/空中机械臂/海绵套管.sldprt
assets_3d/3d打印零件/夹爪装配体 - grip part 3-6.STL
assets_3d/旋转夹爪机械臂/固定底座.SLDPRT
assets_3d/空中机械臂/铜柱50.sldprt
assets_3d/空中机械臂/电池.sldprt
assets_3d/空中机械臂/机臂碳管.sldprt
assets_3d/旋转夹爪机械臂/从动齿轮轴下连杆.SLDPRT
assets_3d/空中机械臂/电池板1.sldprt
assets_3d/3d打印零件/grip part 3.STL
assets_3d/空中机械臂/铜柱21.6.sldprt
assets_3d/空中机械臂/中心板下.sldprt
assets_3d/空中机械臂/HM3.0x8螺丝.sldprt
assets_3d/旋转夹爪机械臂/HTPA28S3M060_A_H5_b.SLDPRT
assets_3d/空中机械臂/12寸反桨.sldprt
assets_3d/平行夹爪机械臂/grip part 3.SLDPRT
assets_3d/旋转夹爪机械臂/grip part 3.SLDPRT
assets_3d/空中机械臂/机臂夹1.sldprt
assets_3d/3d打印零件/夹爪装配体 - 夹爪连接件-1.STL
assets_3d/旋转夹爪机械臂/GB／T889．2-20001型非金属嵌件六角锁紧螺母细牙M10.SLDPRT
assets_3d/空中机械臂/脚架管塞.sldprt
assets_3d/3d打印零件/主动齿直齿M1X24.STL
assets_3d/空中机械臂/机臂夹.sldprt
assets_3d/平行夹爪机械臂/HTPA72S3M060_A_H8_b.SLDPRT
assets_3d/旋转夹爪机械臂/B1C连杆.SLDPRT
assets_3d/空中机械臂/PIXHAWK.sldprt
assets_3d/3d打印零件/B轴轴承压块.STL
assets_3d/空中机械臂/12 铝柱.sldprt
assets_3d/3d打印零件/夹爪装配体 - 主动齿直齿M1X24-1.STL
assets_3d/空中机械臂/电机座 管夹.sldprt
assets_3d/3d打印零件/夹爪装配体 - grip part 3-2.STL
assets_3d/空中机械臂/M3螺母1.sldprt
assets_3d/3d打印零件/夹爪装配体 - 上从动齿直齿M1X37-1.STL
assets_3d/空中机械臂/脚架连接件.sldprt
assets_3d/空中机械臂/电机座板.sldprt
assets_3d/空中机械臂/4112 KV400.sldprt
assets_3d/3d打印零件/B2C轴连杆.STL
assets_3d/平行夹爪机械臂/从动齿轮轴下连杆.SLDPRT
assets_3d/空中机械臂/40 铝柱.sldprt
assets_3d/旋转夹爪机械臂/GB845-1985十字槽盘头自攻螺钉-C型ST2．9×13.SLDPRT
assets_3d/空中机械臂/电池板.sldprt
assets_3d/3d打印零件/夹爪装配体 - pin1-4.STL
assets_3d/平行夹爪机械臂/HTPA28S3M060_A_H5_b.SLDPRT
assets_3d/空中机械臂/减震橡胶.sldprt
assets_3d/空中机械臂/碳板上上.sldprt
assets_3d/平行夹爪机械臂/下深沟球轴承61900.SLDPRT
assets_3d/空中机械臂/HM3.0x6螺丝.sldprt
assets_3d/3d打印零件/旋转底座.STL
assets_3d/旋转夹爪机械臂/夹爪连接件.SLDPRT
assets_3d/空中机械臂/脚架管1.sldprt
assets_3d/3d打印零件/夹爪装配体 - ￠4×M3×30 轴肩螺丝 2018-1.STL
assets_3d/平行夹爪机械臂/舵机圆舵盘渲染2018.SLDPRT
assets_3d/空中机械臂/脚架管2.sldprt
assets_3d/3d打印零件/HTPA28S3M060_A_H5_b.STL
assets_3d/3d打印零件/三角形连杆.STL
assets_3d/3d打印零件/下从动齿直齿M1X37B.STL
assets_3d/3d打印零件/下水平连杆.STL
assets_3d/3d打印零件/固定底座.STL
assets_3d/3d打印零件/夹爪装配体 - HX-12H舵机装配体-1 cross recessed pan head sc__OSS_SCREWS_TYPE1 M2X4-4 H type-N)2018-1.STL
assets_3d/3d打印零件/夹爪装配体 - pin1-1.STL
assets_3d/3d打印零件/夹爪装配体 - pin1-2.STL
assets_3d/3d打印零件/夹爪装配体 - pin1-5.STL
assets_3d/3d打印零件/夹爪装配体 - pin1-6.STL
assets_3d/3d打印零件/夹爪装配体 - 下从动齿直齿M1X37B-1.STL
assets_3d/3d打印零件/夹爪装配体 - 从动齿轮轴下连杆-1.STL
assets_3d/3d打印零件/夹爪装配体 - 夹爪臂-1.STL
assets_3d/3d打印零件/夹爪连接件.STL
assets_3d/平行夹爪机械臂/5×M4×20 轴肩螺丝2018.SLDPRT
assets_3d/平行夹爪机械臂/B1C连杆.SLDPRT
assets_3d/平行夹爪机械臂/B2C轴连杆.SLDPRT
assets_3d/平行夹爪机械臂/CD轴连杆.SLDPRT
assets_3d/平行夹爪机械臂/GB／T276-94深沟球轴承619／5.SLDPRT
assets_3d/平行夹爪机械臂/GB／T6172．2-2000非金属嵌件六角锁紧薄螺母3.SLDPRT
assets_3d/平行夹爪机械臂/GB／T6172．2-2000非金属嵌件六角锁紧薄螺母4.SLDPRT
assets_3d/平行夹爪机械臂/HTBN264S3M_60_info_1_28_72.SLDPRT
assets_3d/平行夹爪机械臂/HX-12H舵机.SLDPRT
assets_3d/平行夹爪机械臂/MG10基体.SLDPRT
assets_3d/平行夹爪机械臂/MG90S 金属舵机单舵臂渲染2018.SLDPRT
assets_3d/平行夹爪机械臂/MG995舵机.SLDPRT
assets_3d/平行夹爪机械臂/cross recessed pan head screws gb(GB_CROSS_SCREWS_TYPE1 M2X4-4 H type-N)2018.SLDPRT
assets_3d/平行夹爪机械臂/cross recessed pan head screws gb(GB_CROSS_SCREWS_TYPE1 M3X6-6 H type-N)2018.SLDPRT
assets_3d/平行夹爪机械臂/pin1.SLDPRT
assets_3d/平行夹爪机械臂/一字槽塞打螺钉 M3×12 2018.SLDPRT
assets_3d/平行夹爪机械臂/上从动齿直齿M1X37.SLDPRT
assets_3d/平行夹爪机械臂/上水平连杆.SLDPRT
assets_3d/平行夹爪机械臂/上深沟球轴承61809.SLDPRT
assets_3d/平行夹爪机械臂/下水平连杆.SLDPRT
assets_3d/平行夹爪机械臂/主动齿直齿M1X24.SLDPRT
assets_3d/平行夹爪机械臂/内径3mm外径5mm厚4mm轴套.SLDPRT
assets_3d/平行夹爪机械臂/大舵机渲染2018.SLDPRT
assets_3d/平行夹爪机械臂/夹爪支架.SLDPRT
assets_3d/平行夹爪机械臂/夹爪臂.SLDPRT
assets_3d/平行夹爪机械臂/易格斯轴承GFM-04050-04 2018.SLDPRT
assets_3d/平行夹爪机械臂/易格斯轴承GFM-0506-05 2018.SLDPRT
assets_3d/平行夹爪机械臂/末端爪1.SLDPRT
assets_3d/平行夹爪机械臂/直径5长135光轴.SLDPRT
assets_3d/平行夹爪机械臂/舵机橡胶圈渲染2018.SLDPRT
assets_3d/平行夹爪机械臂/长拉杆.SLDPRT
assets_3d/平行夹爪机械臂/限位盖.SLDPRT
assets_3d/平行夹爪机械臂/￠4×M3×12 轴肩螺丝 2018.SLDPRT
assets_3d/平行夹爪机械臂/￠5×M4×30 轴肩螺丝渲染 2018.SLDPRT
assets_3d/旋转夹爪机械臂/B2轴摇杆.SLDPRT
assets_3d/旋转夹爪机械臂/GB／T6172．2-2000非金属嵌件六角锁紧薄螺母3.SLDPRT
assets_3d/旋转夹爪机械臂/GB／T6172．2-2000非金属嵌件六角锁紧薄螺母4.SLDPRT
assets_3d/旋转夹爪机械臂/GB／T70．1-2000内六角圆柱头螺钉M10×50.SLDPRT
assets_3d/旋转夹爪机械臂/GB／T70．1-2000内六角圆柱头螺钉M3×12.SLDPRT
assets_3d/旋转夹爪机械臂/HX-12H舵机.SLDPRT
assets_3d/旋转夹爪机械臂/bc连杆.SLDPRT
assets_3d/旋转夹爪机械臂/b轴摇杆连杆.SLDPRT
assets_3d/旋转夹爪机械臂/cd连杆.SLDPRT
assets_3d/旋转夹爪机械臂/三角形连杆.SLDPRT
assets_3d/旋转夹爪机械臂/上水平连杆.SLDPRT
assets_3d/旋转夹爪机械臂/上深沟球轴承61809.SLDPRT
assets_3d/旋转夹爪机械臂/下从动齿直齿M1X37B.SLDPRT
assets_3d/旋转夹爪机械臂/夹爪支架.SLDPRT
assets_3d/旋转夹爪机械臂/方案-固定底座.SLDPRT
assets_3d/旋转夹爪机械臂/方案-新旋转底座.SLDPRT
assets_3d/旋转夹爪机械臂/旋转底座.SLDPRT
assets_3d/旋转夹爪机械臂/机械臂草图模拟.SLDPRT
assets_3d/旋转夹爪机械臂/直齿M1X17.SLDPRT
assets_3d/旋转夹爪机械臂/￠5×M4×30 轴肩螺丝渲染 2018.SLDPRT
assets_3d/空中机械臂/HM3.0x20螺丝.sldprt
assets_3d/空中机械臂/中心板下 - 副本.sldprt
