hrx2025lucky-lab/flyarm-aerial-manipulation/(commit log)

2026-09-01 feat: Flyarm 空中机械臂 — RL 高层决策 + 串级 LADRC 内环
    硕士课题：四旋翼 + 4-DoF 机械臂 + 二指夹爪的空中操作平台，
    从单机抓取递进到双机协同搬运。
    flyarm/ Isaac Lab RL 环境（Python 4556 行）
    - cascade_ladrc.py 串级 LADRC，纯 torch，4096 并行环境同步运算
    LESO 在线估扰 + 重心/负载前馈补偿
    - flyarm_*_env.py 单机抓取 / 视觉 / 平行夹爪 / 双机协作
    - flyarm_coop_grasp_marl_env.py 分布式 CTDE / MAPPO
    matlab_control/ MATLAB + Simulink（.m 3425 行 + 2 个 .slx）
    - 拉格朗日法推导浮动基耦合动力学（10 维广义速度，10x10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
    [12 铝柱.sldprt, 12寸反桨.sldprt, 3d打印零件.SLDASM, 40 铝柱.sldprt, 4112 KV400.sldprt, 5×M4×20 轴肩螺丝2018.SLDPRT, A轴轴承压块.STL, B1C连杆.SLDPRT]
2026-09-14 docs: showcase FlyArm hardware assembly
2026-09-15 docs: replace hardware photos with high-resolution versions
    Swap the two blurry low-resolution assembly photos (6.4KB) for the
    original 1706x1279 captures and bump the README display width from
    320px to 480px.
